lflaherty/ev-ecu/hardware/kicad_project/AIN_sim.png

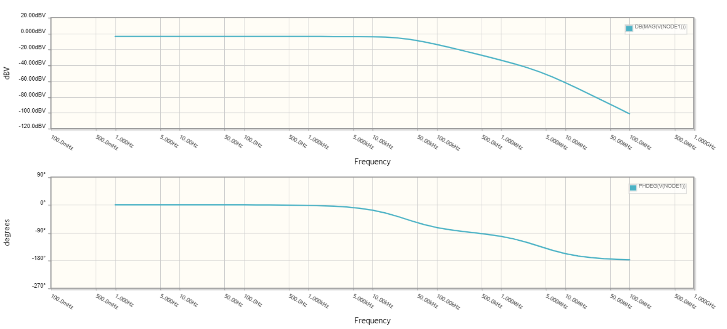
hardware/kicad_project/AIN_sim.png
