lflaherty/ev-ecu/hardware/kicad_project/GPS Antenna.SLDASM

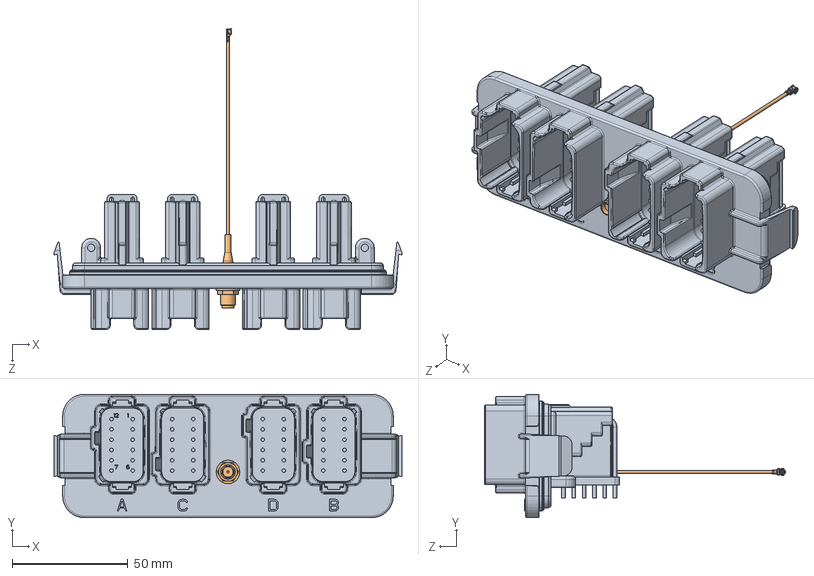
[picture p2: CAD file, 2026-08-13]
hardware/kicad_project/GPS Antenna.SLDASM
150.2 x 53.3 x 130.0 mm
c-dt13-48pabcd-r015-99-3d - COLOUR
SMA(F)-MHF-IPEX (F)-U.FL-LP-068-0.35m.step
