lflaherty/ev-ecu/hardware/kicad_project/ECU.kicad_pcb

## KiCad design hardware/kicad_project/ECU.kicad_pcb (2026-08-13)

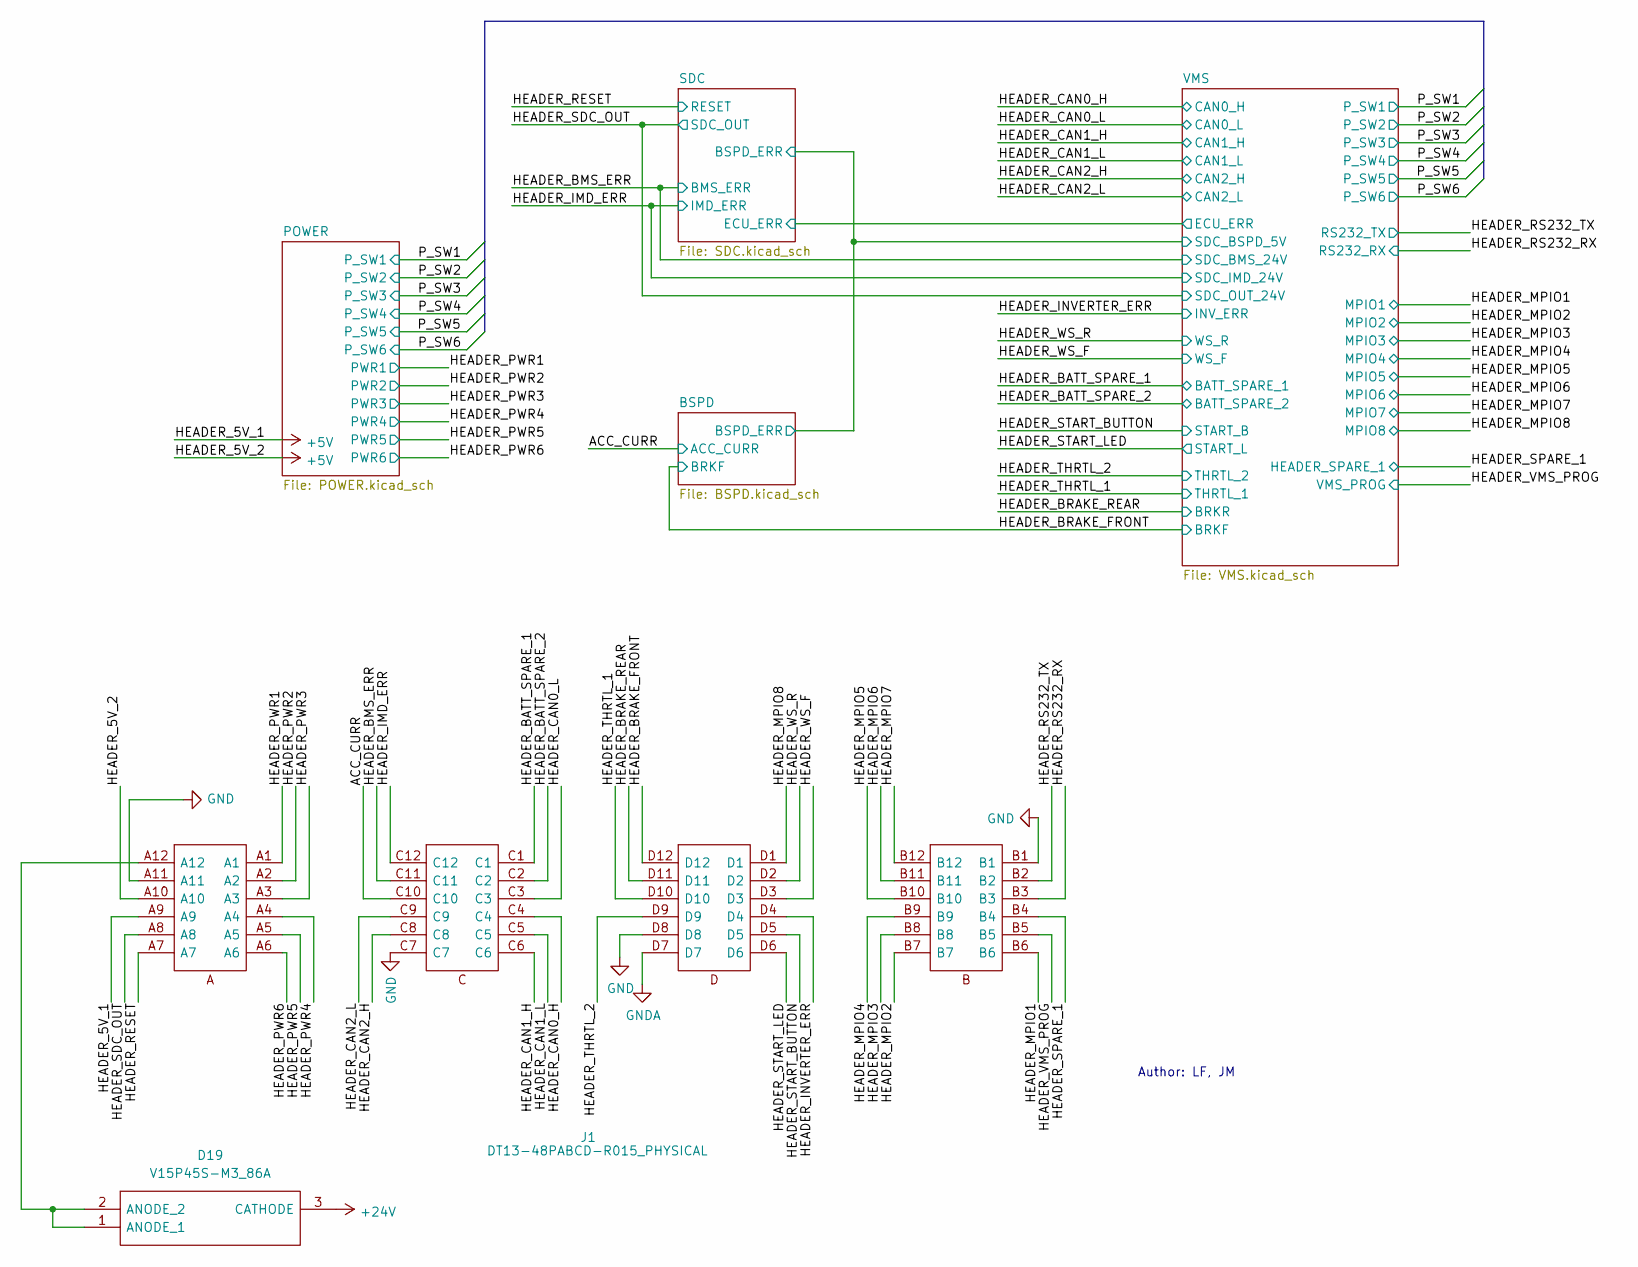
[picture p20: schematic ECU.kicad_sch]

Parts:
D19: V15P45S-M3_86A; V15P45SM387A; Manufacturer_Part_Number V15P45S-M3/87A; Mouser Part Number 78-V15P45S-M387A
J1: DT13-48PABCD-R015_PHYSICAL; DT1348PABCDR015_PHYSICAL; Manufacturer_Part_Number DT13-48PABCD-R015; Mouser Part Number 571-DT13-48PABCDR015

Connections:
+5V: J1.A9, J1.A10; also elsewhere on the board
+24V: D19.3 (CATHODE); also elsewhere on the board
/BSPD/ACC_CURR: J1.C10; also elsewhere on the board
/BSPD/BRKF: J1.D12; also elsewhere on the board
/POWER/PWR1: J1.A1; also elsewhere on the board
/POWER/PWR2: J1.A2; also elsewhere on the board
/POWER/PWR3: J1.A3; also elsewhere on the board
/POWER/PWR4: J1.A4; also elsewhere on the board
/POWER/PWR5: J1.A5; also elsewhere on the board
/POWER/PWR6: J1.A6; also elsewhere on the board
/SDC/BMS_ERR: J1.C11; also elsewhere on the board
/SDC/IMD_ERR: J1.C12; also elsewhere on the board
/SDC/RESET: J1.A7; also elsewhere on the board
/SDC/SDC_OUT: J1.A8; also elsewhere on the board
/VMS/BATT_SPARE_1: J1.C1; also elsewhere on the board
/VMS/BATT_SPARE_2: J1.C2; also elsewhere on the board
/VMS/BRKR: J1.D11; also elsewhere on the board
/VMS/CAN0_H: J1.C3; also elsewhere on the board
/VMS/CAN0_L: J1.C4; also elsewhere on the board
/VMS/CAN1_H: J1.C5; also elsewhere on the board
/VMS/CAN1_L: J1.C6; also elsewhere on the board
/VMS/CAN2_H: J1.C9; also elsewhere on the board
/VMS/CAN2_L: J1.C8; also elsewhere on the board
/VMS/HEADER_SPARE_1: J1.B4; also elsewhere on the board
/VMS/INV_ERR: J1.D4; also elsewhere on the board
/VMS/MPIO/MPIO1: J1.B6; also elsewhere on the board
/VMS/MPIO/MPIO2: J1.B7; also elsewhere on the board
/VMS/MPIO/MPIO3: J1.B8; also elsewhere on the board
/VMS/MPIO/MPIO4: J1.B9; also elsewhere on the board
/VMS/MPIO/MPIO5: J1.B10; also elsewhere on the board
/VMS/MPIO/MPIO6: J1.B11; also elsewhere on the board
/VMS/MPIO/MPIO7: J1.B12; also elsewhere on the board
/VMS/MPIO/MPIO8: J1.D1; also elsewhere on the board
/VMS/RS232_RX: J1.B3; also elsewhere on the board
/VMS/RS232_TX: J1.B2; also elsewhere on the board
/VMS/START_B: J1.D5; also elsewhere on the board
/VMS/START_L: J1.D6; also elsewhere on the board
/VMS/THRTL_1: J1.D10; also elsewhere on the board
/VMS/THRTL_2: J1.D9; also elsewhere on the board
/VMS/VMS_PROG: J1.B5; also elsewhere on the board
/VMS/WS_F: J1.D3; also elsewhere on the board
/VMS/WS_R: J1.D2; also elsewhere on the board
GND: J1.A11, J1.B1, J1.C7, J1.D8; also elsewhere on the board
GNDA: J1.D7
unnamed: D19.1 (ANODE_1), D19.2 (ANODE_2), J1.A12

Notes on the sheet:
Author: LF, JM

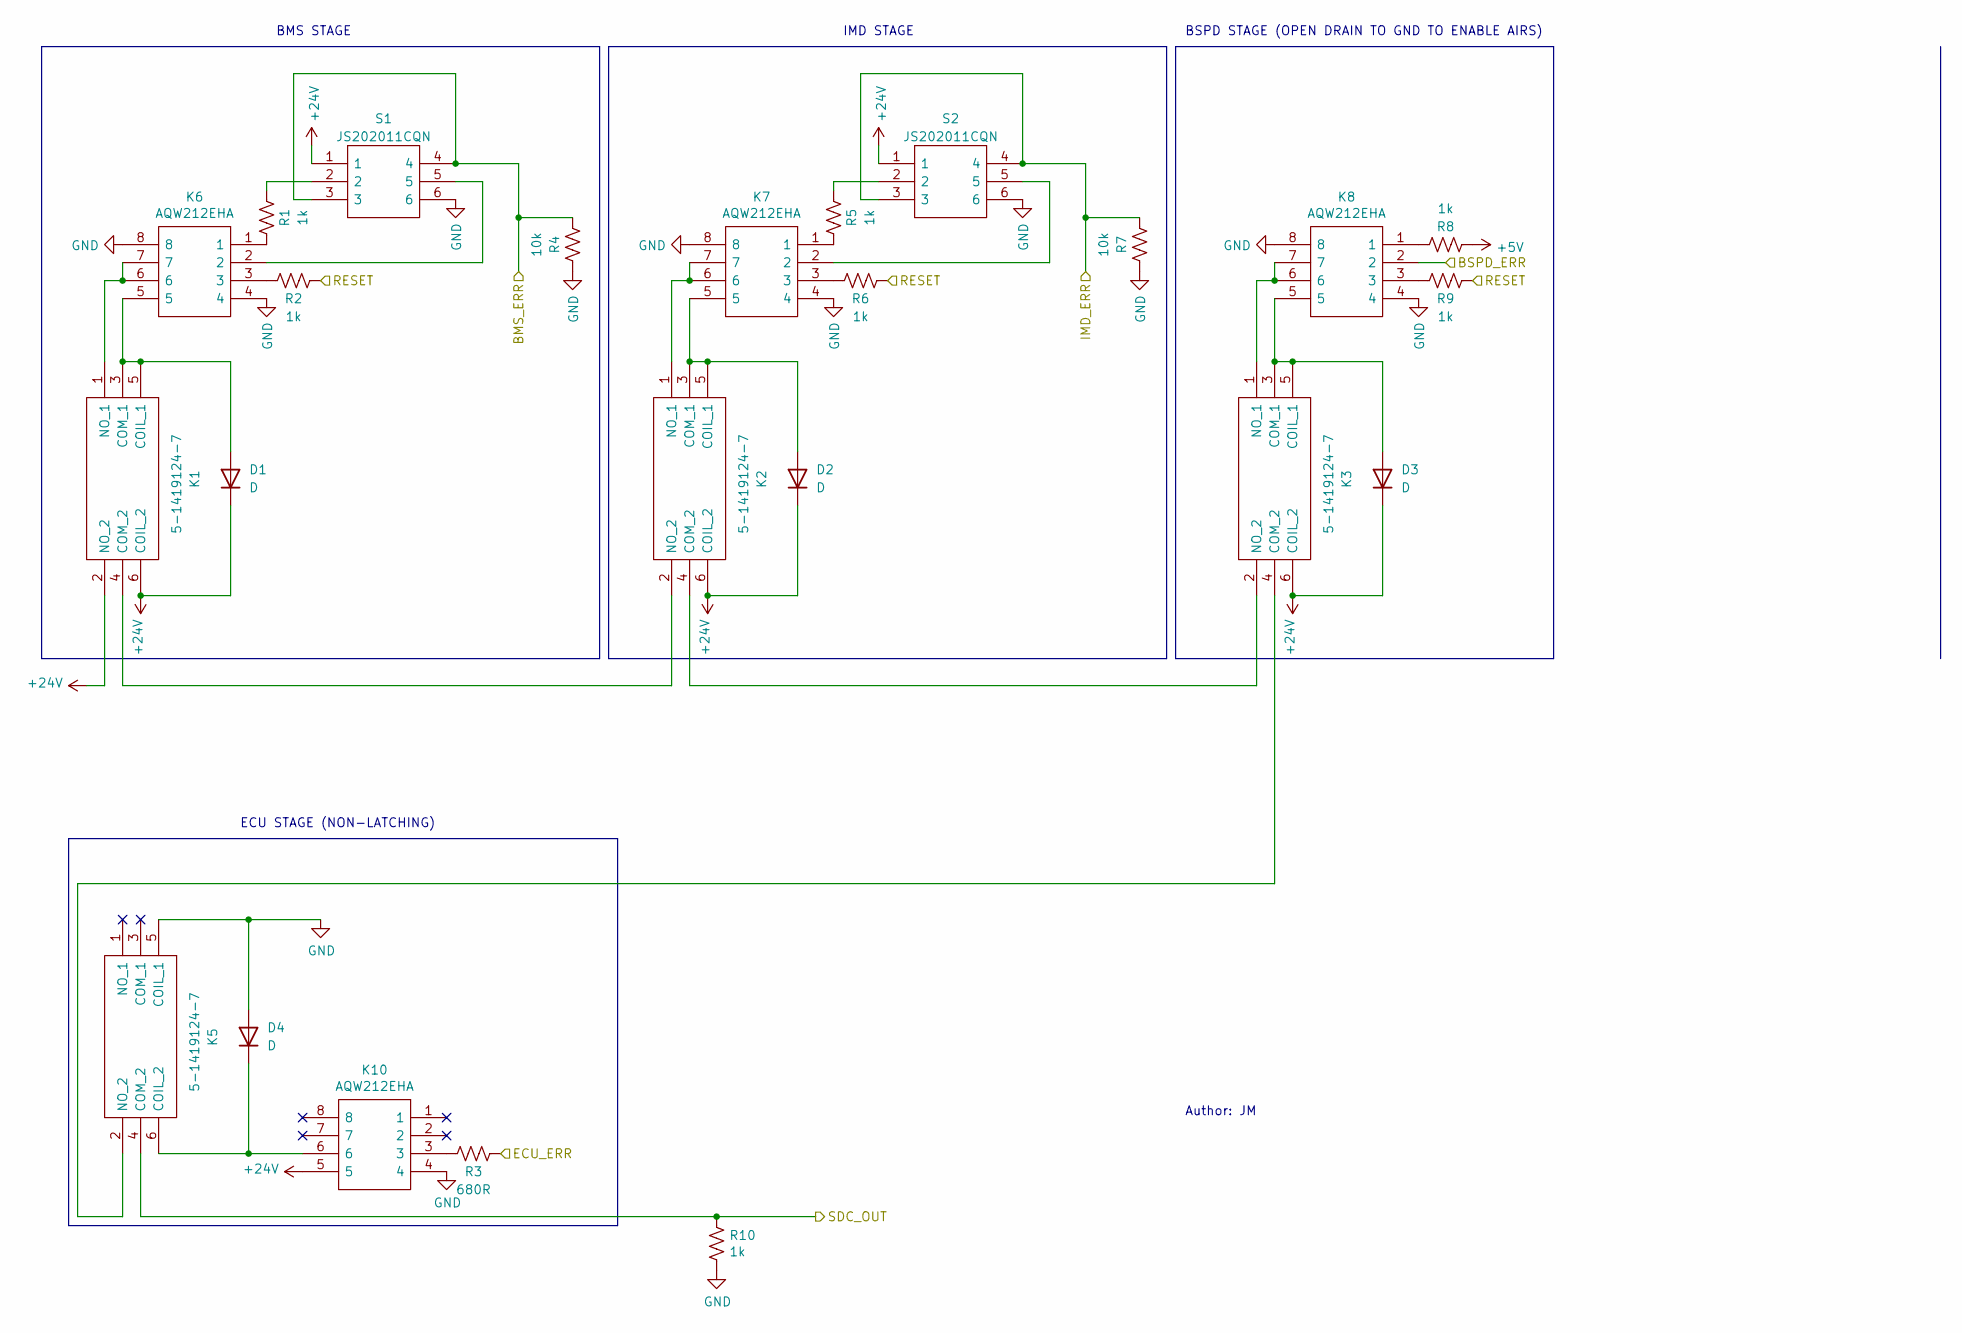
[picture p21: schematic SDC.kicad_sch]

Parts:
D1, D2, D3, D4: D; D_SMA
K1, K2, K3, K5: 5-1419124-7; 514191247; Manufacturer_Part_Number 5-1419124-7; Mouser Part Number 655-5-1419124-7
K6, K7, K8, K10: AQW212EHA; SOP254P962X275-8N; Manufacturer_Part_Number AQW212EHA; Mouser Part Number 769-AQW212EHA
R1, R2, R5, R6, R8, R9, R10: 1k; R_0805_2012Metric
R3: 680R; R_0805_2012Metric
R4, R7: 10k; R_0805_2012Metric
S1, S2: JS202011CQN; Manufacturer_Part_Number JS202011CQN; Mouser Part Number 611-JS202011CQN

Connections:
+5V: R8.2; also elsewhere on the board
+24V: D1.1 (K), D2.1 (K), D3.1 (K), K1.2 (NO_2), K1.6 (COIL_2), K2.6 (COIL_2), K3.6 (COIL_2), K10.5, S1.1, S2.1; also elsewhere on the board
/BSPD/BSPD_ERR: K8.2; also elsewhere on the board
/SDC/BMS_ERR: R4.2, S1.3, S1.4; also elsewhere on the board
/SDC/ECU_ERR: R3.1; also elsewhere on the board
/SDC/IMD_ERR: R7.2, S2.3, S2.4; also elsewhere on the board
/SDC/RESET: R2.1, R6.1, R9.1; also elsewhere on the board
/SDC/SDC_OUT: K5.4 (COM_2), R10.1; also elsewhere on the board
GND: D4.2 (A), K5.5 (COIL_1), K6.4, K6.8, K7.4, K7.8, K8.4, K8.8, K10.4, R4.1, R7.1, R10.2, S1.6, S2.6; also elsewhere on the board
unnamed: D1.2 (A), K1.3 (COM_1), K1.5 (COIL_1), K6.5
unnamed: D2.2 (A), K2.3 (COM_1), K2.5 (COIL_1), K7.5
unnamed: D3.2 (A), K3.3 (COM_1), K3.5 (COIL_1), K8.5
unnamed: D4.1 (K), K5.6 (COIL_2), K10.6
unnamed: K1.1 (NO_1), K6.6, K6.7
unnamed: K1.4 (COM_2), K2.2 (NO_2)
unnamed: K2.1 (NO_1), K7.6, K7.7
unnamed: K2.4 (COM_2), K3.2 (NO_2)
unnamed: K3.1 (NO_1), K8.6, K8.7
unnamed: K3.4 (COM_2), K5.2 (NO_2)
unnamed: K6.1, R1.2
unnamed: K6.2, S1.5
unnamed: K6.3, R2.2
unnamed: K7.1, R5.2
unnamed: K7.2, S2.5
unnamed: K7.3, R6.2
unnamed: K8.1, R8.1
unnamed: K8.3, R9.2
unnamed: K10.3, R3.2
unnamed: R1.1, S1.2
unnamed: R5.1, S2.2

Notes on the sheet:
ECU STAGE (NON-LATCHING)
BMS STAGE
Author: JM
BSPD STAGE (OPEN DRAIN TO GND TO ENABLE AIRS)
IMD STAGE

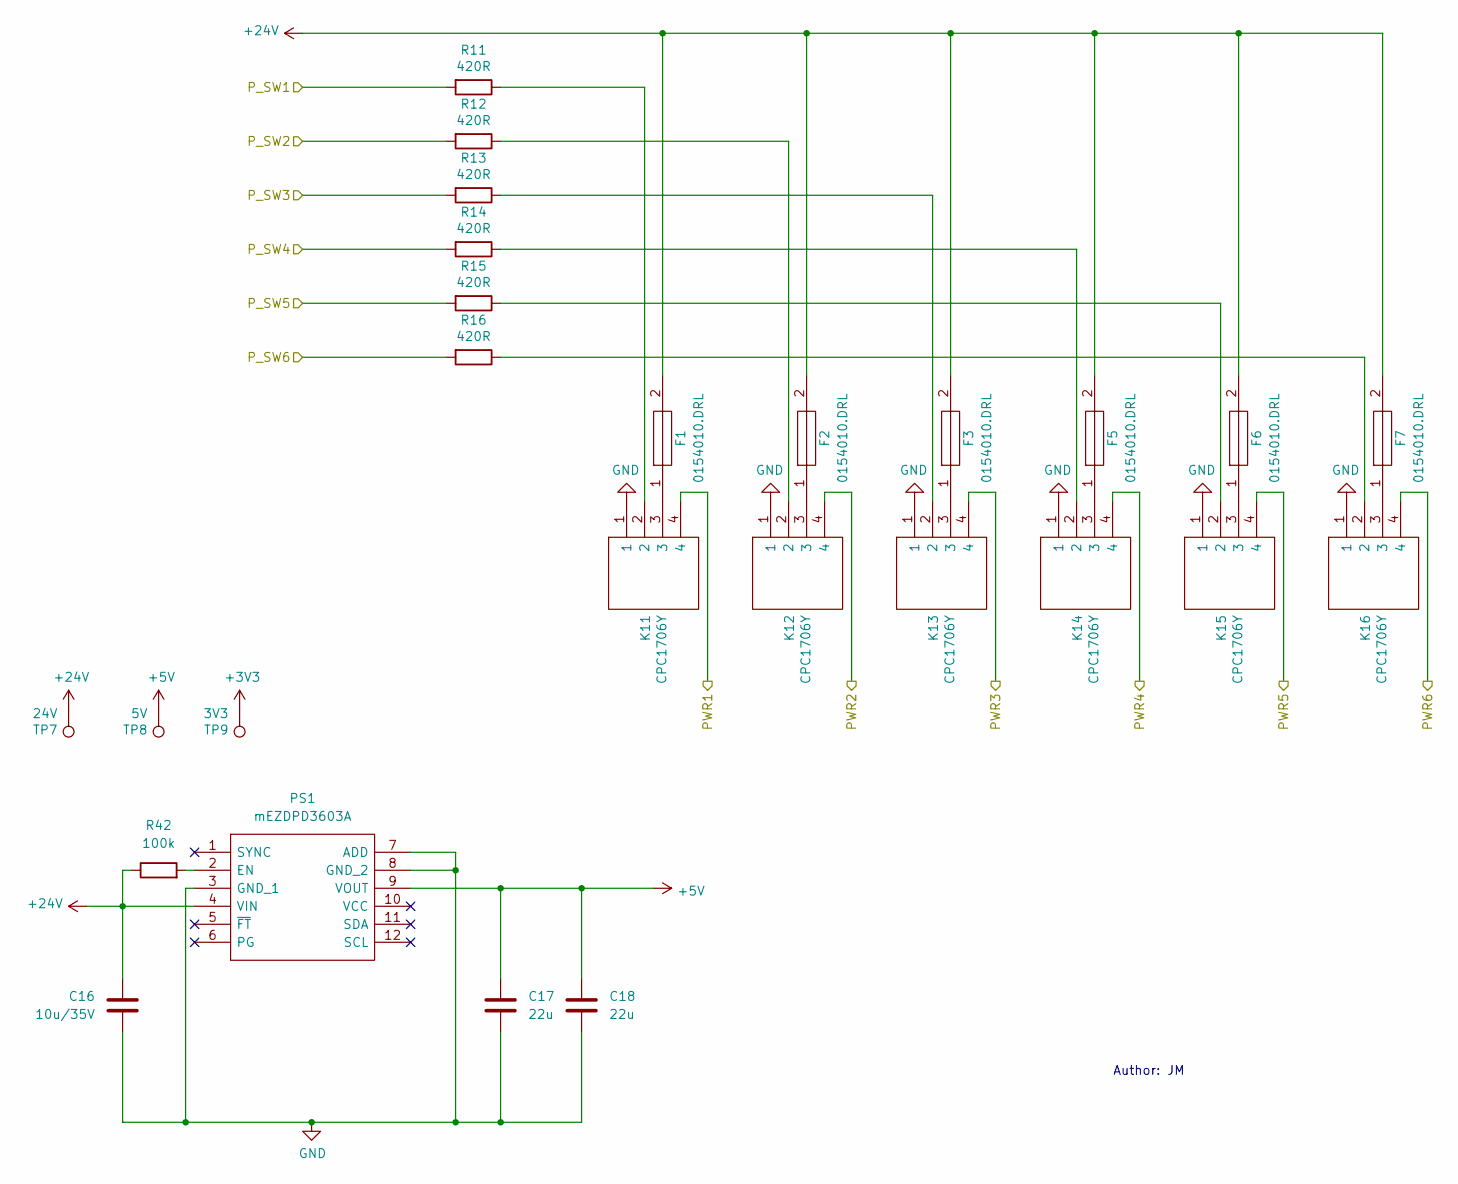
[picture p22: schematic POWER.kicad_sch]

Parts:
C16: 10u/35V; C_0805_2012Metric
C17, C18: 22u; C_1206_3216Metric
F1, F2, F3, F5, F6, F7: 0154010.DRL; 0154010DRL; Manufacturer_Part_Number 0154010.DRL; Mouser Part Number 576-0154010.DRL
K11, K12, K13, K14, K15, K16: CPC1706Y; Manufacturer_Part_Number CPC1706Y; Mouser Part Number 849-CPC1706Y
PS1: mEZDPD3603A; Manufacturer_Part_Number mEZDPD3603A; Mouser Part Number 946-MEZDPD3603A
R11, R12, R13, R14, R15, R16: 420R; R_0805_2012Metric
R42: 100k; R_0805_2012Metric
TP7: 24V; TestPoint_THTPad_D2.5mm_Drill1.2mm
TP8: 5V; TestPoint_THTPad_D2.5mm_Drill1.2mm
TP9: 3V3; TestPoint_THTPad_D2.5mm_Drill1.2mm

Connections:
+5V: C17.1, C18.1, PS1.9 (VOUT), TP8.1; also elsewhere on the board
+24V: C16.2, F1.2, F2.2, F3.2, F5.2, F6.2, F7.2, PS1.4 (VIN), R42.1, TP7.1; also elsewhere on the board
/POWER/PWR1: K11.4; also elsewhere on the board
/POWER/PWR2: K12.4; also elsewhere on the board
/POWER/PWR3: K13.4; also elsewhere on the board
/POWER/PWR4: K14.4; also elsewhere on the board
/POWER/PWR5: K15.4; also elsewhere on the board
/POWER/PWR6: K16.4; also elsewhere on the board
/POWER/P_SW1: R11.2; also elsewhere on the board
/POWER/P_SW2: R12.2; also elsewhere on the board
/POWER/P_SW3: R13.2; also elsewhere on the board
/POWER/P_SW4: R14.2; also elsewhere on the board
/POWER/P_SW5: R15.2; also elsewhere on the board
/POWER/P_SW6: R16.2; also elsewhere on the board
GND: C16.1, C17.2, C18.2, K11.1, K12.1, K13.1, K14.1, K15.1, K16.1, PS1.3 (GND_1), PS1.7 (ADD), PS1.8 (GND_2); also elsewhere on the board
unnamed: F1.1, K11.3
unnamed: F2.1, K12.3
unnamed: F3.1, K13.3
unnamed: F5.1, K14.3
unnamed: F6.1, K15.3
unnamed: F7.1, K16.3
unnamed: K11.2, R11.1
unnamed: K12.2, R12.1
unnamed: K13.2, R13.1
unnamed: K14.2, R14.1
unnamed: K15.2, R15.1
unnamed: K16.2, R16.1
unnamed: PS1.2 (EN), R42.2

Notes on the sheet:
Author: JM

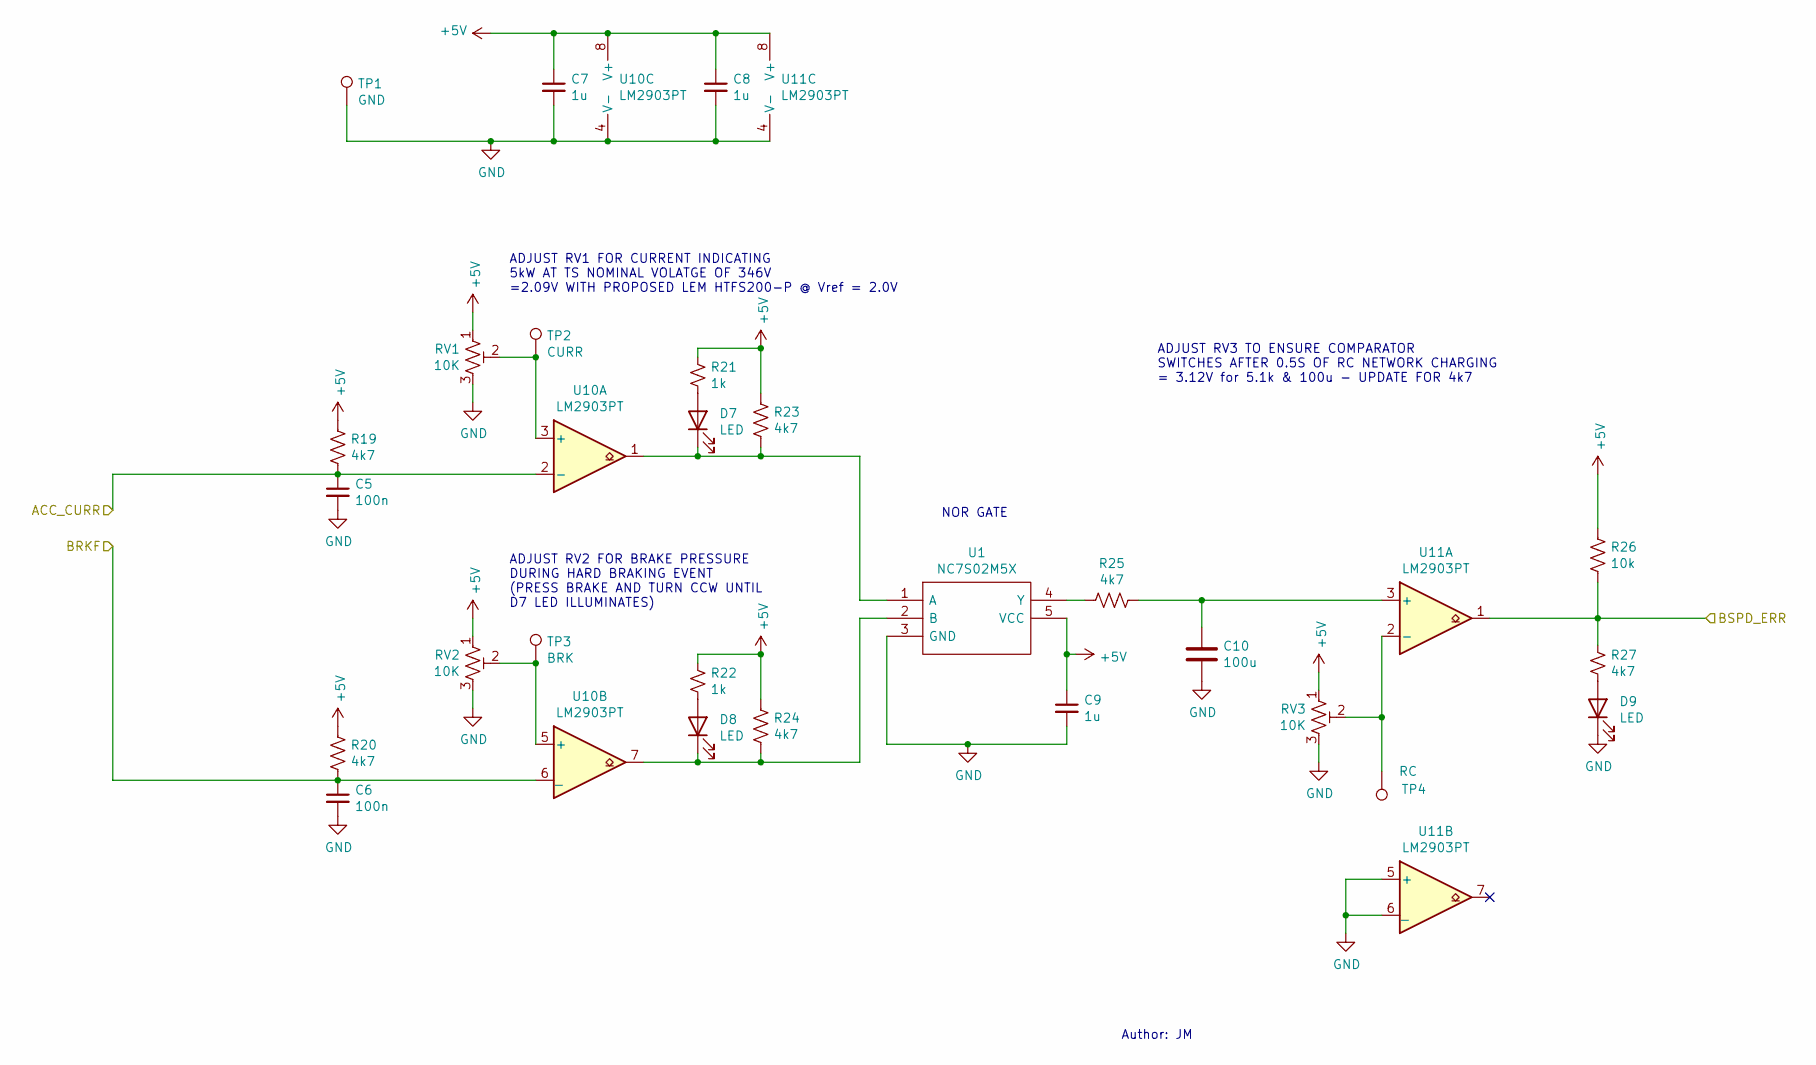
[picture p23: schematic BSPD.kicad_sch]

Parts:
C5, C6: 100n; C_0805_2012Metric
C7, C8, C9: 1u; C_0805_2012Metric
C10: 100u; C_1206_3216Metric
D7, D8, D9: LED; LED_0805_2012Metric
R19, R20, R23, R24, R25, R27: 4k7; R_0805_2012Metric
R21, R22: 1k; R_0805_2012Metric
R26: 10k; R_0805_2012Metric
RV1, RV2, RV3: 10K; 3306F1103
TP1: GND; TestPoint_THTPad_D2.5mm_Drill1.2mm
TP2: CURR; TestPoint_THTPad_D2.5mm_Drill1.2mm
TP3: BRK; TestPoint_THTPad_D2.5mm_Drill1.2mm
TP4: RC; TestPoint_THTPad_D2.5mm_Drill1.2mm
U1: NC7S02M5X; SOT95P280X125-5N; Manufacturer_Part_Number NC7S02M5X; Mouser Part Number 512-NC7S02M5X
U10, U11: LM2903PT; TSSOP-8_4.4x3mm_P0.65mm

Connections:
+5V: C7.1, C8.1, C9.1, R19.1, R20.1, R21.1, R22.1, R23.1, R24.1, R26.1, RV1.1, RV2.1, RV3.1, U1.5 (VCC), U10.8 (V+), U11.8 (V+); also elsewhere on the board
/BSPD/ACC_CURR: C5.1, R19.2, U10.2 (-); also elsewhere on the board
/BSPD/BRKF: C6.1, R20.2, U10.6 (_); also elsewhere on the board
/BSPD/BSPD_ERR: R26.2, R27.1, U11.1; also elsewhere on the board
GND: C5.2, C6.2, C7.2, C8.2, C9.2, C10.2, D9.1 (K), RV1.3, RV2.3, RV3.3, TP1.1, U1.3 (GND), U10.4 (V-), U11.4 (V-), U11.5 (+), U11.6 (_); also elsewhere on the board
unnamed: C10.1, R25.1, U11.3 (+)
unnamed: D7.1 (K), R23.2, U1.1 (A), U10.1
unnamed: D7.2 (A), R21.2
unnamed: D8.1 (K), R24.2, U1.2 (B), U10.7
unnamed: D8.2 (A), R22.2
unnamed: D9.2 (A), R27.2
unnamed: R25.2, U1.4 (Y)
unnamed: RV1.2, TP2.1, U10.3 (+)
unnamed: RV2.2, TP3.1, U10.5 (+)
unnamed: RV3.2, TP4.1, U11.2 (-)

Notes on the sheet:
ADJUST RV1 FOR CURRENT INDICATING 5kW AT TS NOMINAL VOLATGE OF 346V =2.09V WITH PROPOSED LEM HTFS200-P @ Vref = 2.0V
NOR GATE
ADJUST RV3 TO ENSURE COMPARATOR SWITCHES AFTER 0.5S OF RC NETWORK CHARGING = 3.12V for 5.1k & 100u - UPDATE FOR 4k7
Author: JM
ADJUST RV2 FOR BRAKE PRESSURE DURING HARD BRAKING EVENT (PRESS BRAKE AND TURN CCW UNTIL D7 LED ILLUMINATES)

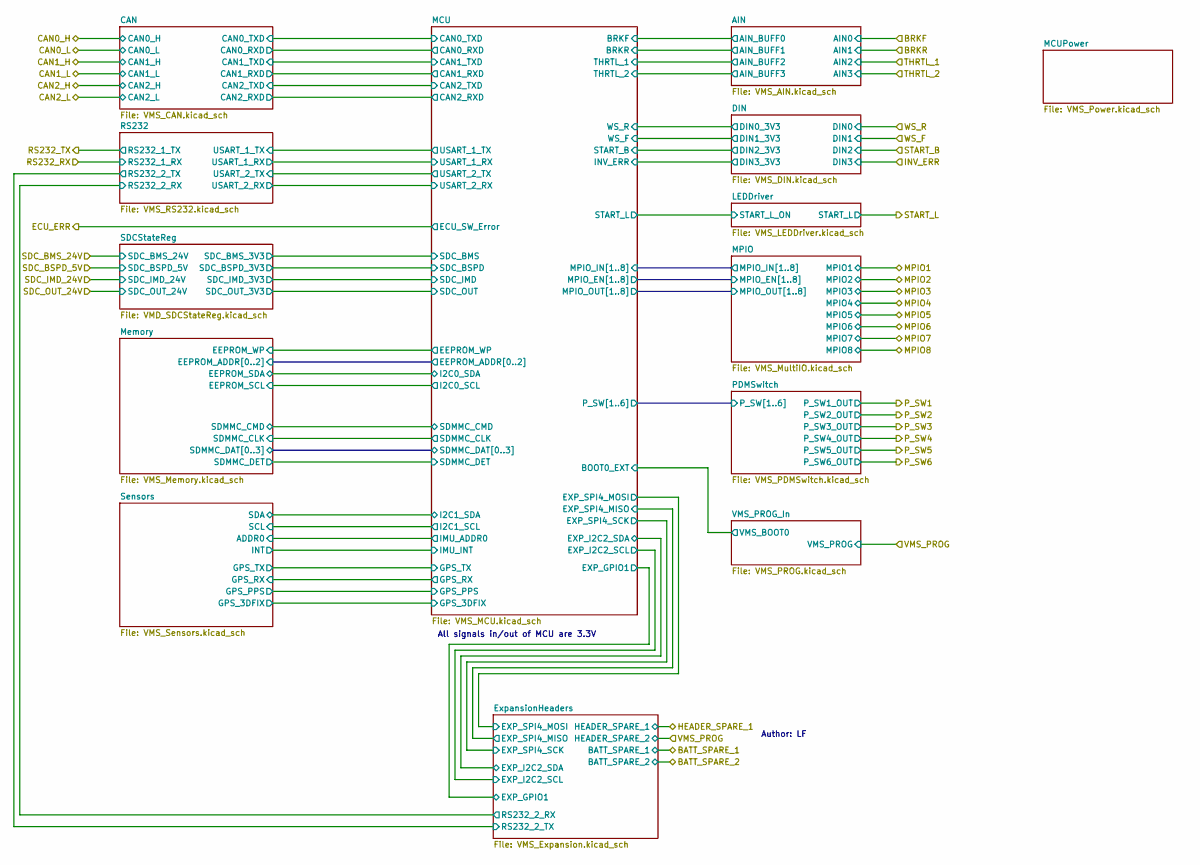
[picture p24: schematic VMS.kicad_sch]

Notes on the sheet:
All signals in/out of MCU are 3.3V
Author: LF

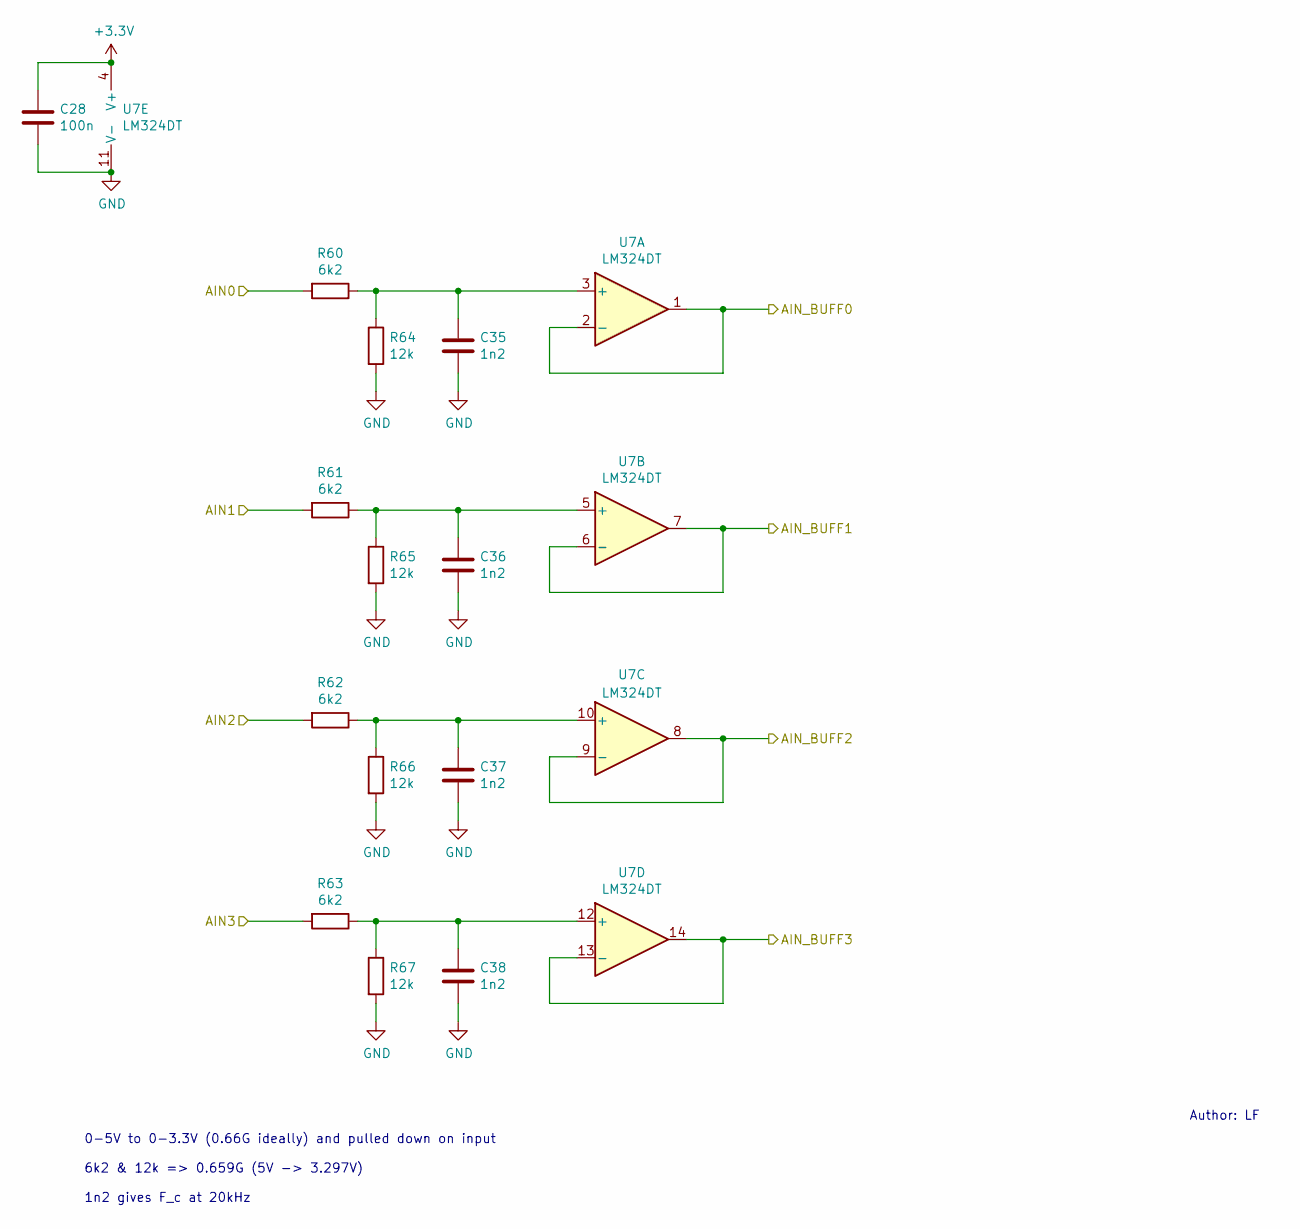
[picture p25: schematic VMS_AIN.kicad_sch]

Parts:
C28: 100n; C_0805_2012Metric
C35, C36, C37, C38: 1n2; C_0805_2012Metric
R60, R61, R62, R63: 6k2; R_0805_2012Metric
R64, R65, R66, R67: 12k; R_0805_2012Metric
U7: LM324DT; SOIC-14_3.9x8.7mm_P1.27mm

Connections:
/BSPD/BRKF: R60.2; also elsewhere on the board
/VMS/AIN/AIN_BUFF0: U7.1, U7.2 (-); also elsewhere on the board
/VMS/AIN/AIN_BUFF1: U7.6 (-), U7.7; also elsewhere on the board
/VMS/AIN/AIN_BUFF2: U7.8, U7.9 (-); also elsewhere on the board
/VMS/AIN/AIN_BUFF3: U7.13 (-), U7.14; also elsewhere on the board
/VMS/BRKR: R61.2; also elsewhere on the board
/VMS/THRTL_1: R62.2; also elsewhere on the board
/VMS/THRTL_2: R63.2; also elsewhere on the board
GND: C28.2, C35.2, C36.2, C37.2, C38.2, R64.2, R65.2, R66.2, R67.2, U7.11 (V-); also elsewhere on the board
unnamed: C35.1, R60.1, R64.1, U7.3 (+)
unnamed: C36.1, R61.1, R65.1, U7.5 (+)
unnamed: C37.1, R62.1, R66.1, U7.10 (+)
unnamed: C38.1, R63.1, R67.1, U7.12 (+)

Notes on the sheet:
0-5V to 0-3.3V (0.66G ideally) and pulled down on input 6k2 & 12k => 0.659G (5V -> 3.297V) 1n2 gives F_c at 20kHz
Author: LF

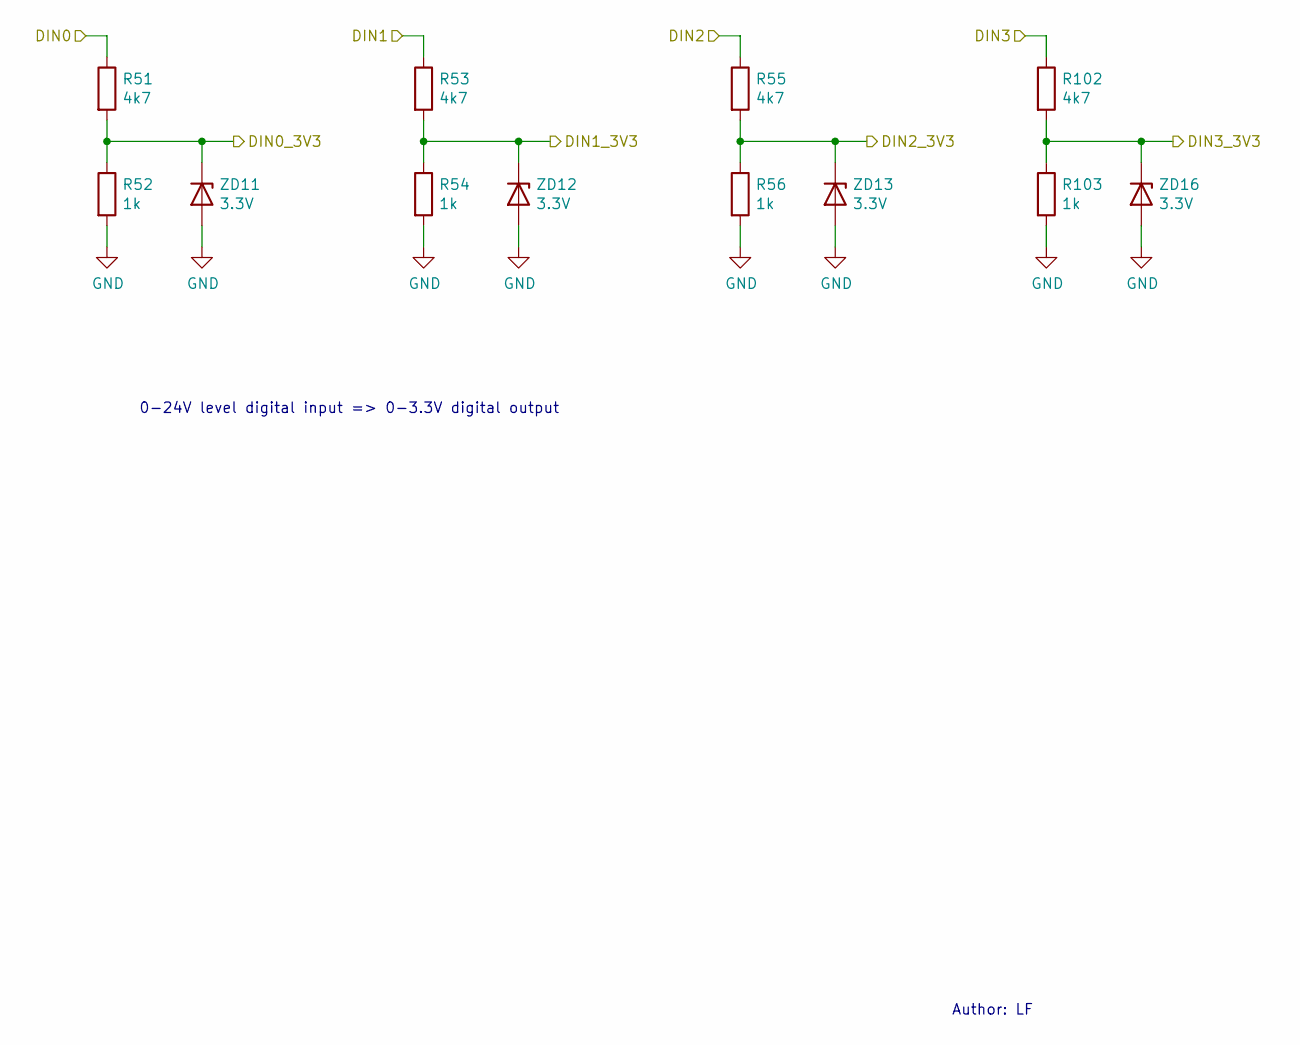
[picture p26: schematic VMS_DIN.kicad_sch]

Parts:
R51, R53, R55, R102: 4k7; R_0805_2012Metric
R52, R54, R56, R103: 1k; R_0805_2012Metric
ZD11, ZD12, ZD13, ZD16: 3.3V; D_MiniMELF

Connections:
/VMS/DIN/DIN0_3V3: R51.2, R52.1, ZD11.1 (K); also elsewhere on the board
/VMS/DIN/DIN1_3V3: R53.2, R54.1, ZD12.1 (K); also elsewhere on the board
/VMS/DIN/DIN2_3V3: R55.2, R56.1, ZD13.1 (K); also elsewhere on the board
/VMS/DIN/DIN3_3V3: R102.2, R103.1, ZD16.1 (K); also elsewhere on the board
/VMS/INV_ERR: R102.1; also elsewhere on the board
/VMS/START_B: R55.1; also elsewhere on the board
/VMS/WS_F: R53.1; also elsewhere on the board
/VMS/WS_R: R51.1; also elsewhere on the board
GND: R52.2, R54.2, R56.2, R103.2, ZD11.2 (A), ZD12.2 (A), ZD13.2 (A), ZD16.2 (A); also elsewhere on the board

Notes on the sheet:
Author: LF
0-24V level digital input => 0-3.3V digital output

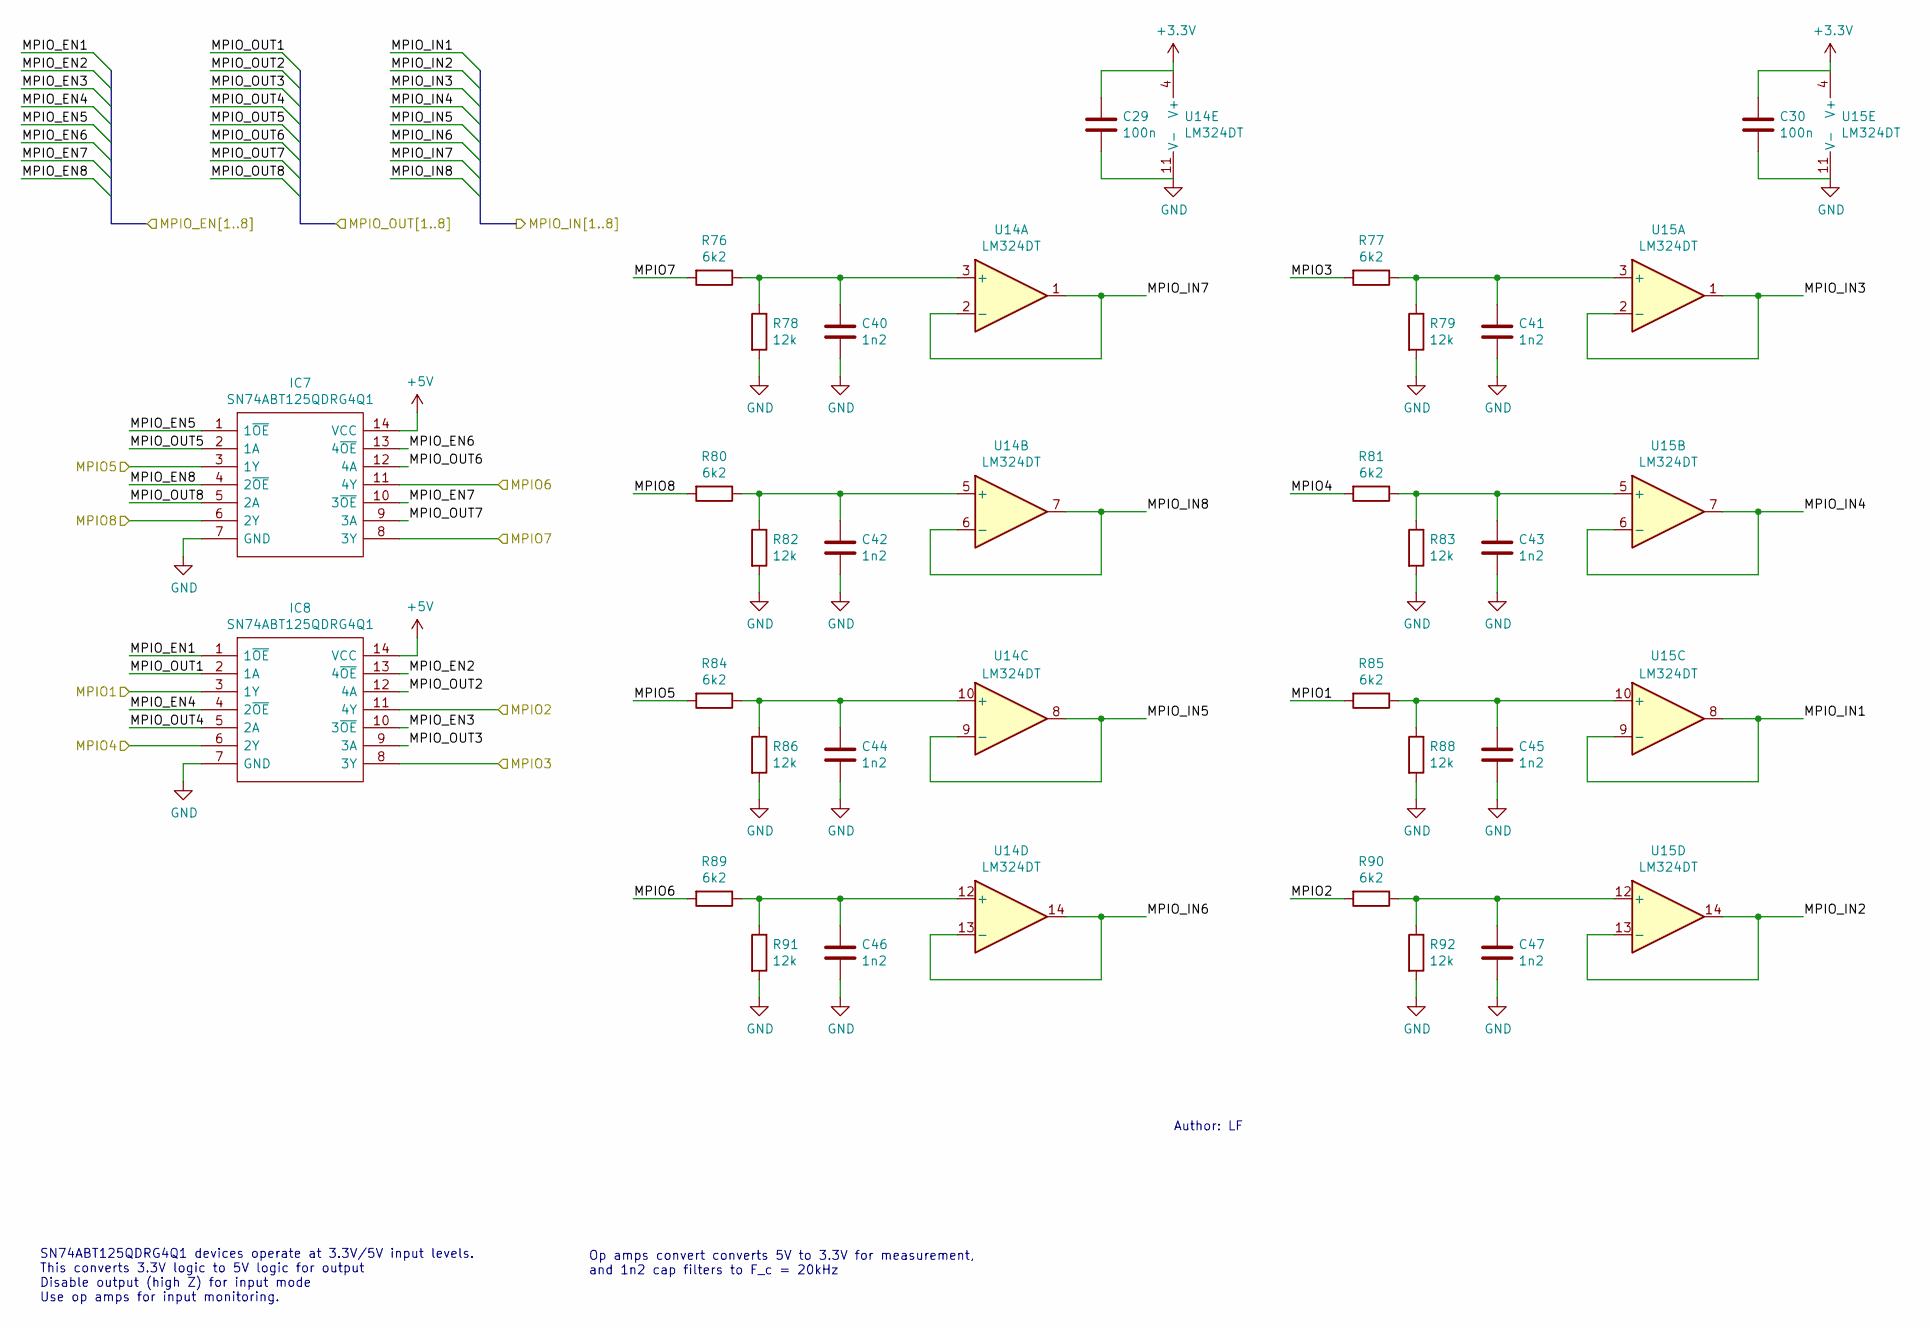
[picture p27: schematic VMS_MultiIO.kicad_sch]

Parts:
C29, C30: 100n; C_0805_2012Metric
C40, C41, C42, C43, C44, C45, C46, C47: 1n2; C_0805_2012Metric
IC7, IC8: SN74ABT125QDRG4Q1; SOIC-14_3.9x8.7mm_P1.27mm; Manufacturer_Part_Number SN74ABT125QDRG4Q1; Mouser Part Number 595-N74ABT125QDRG4Q1
R76, R77, R80, R81, R84, R85, R89, R90: 6k2; R_0805_2012Metric
R78, R79, R82, R83, R86, R88, R91, R92: 12k; R_0805_2012Metric
U14, U15: LM324DT; SOIC-14_3.9x8.7mm_P1.27mm

Connections:
+5V: IC7.14 (VCC), IC8.14 (VCC); also elsewhere on the board
/VMS/MCU/MPIO_EN1: IC8.1 (1~OE); also elsewhere on the board
/VMS/MCU/MPIO_EN2: IC8.13 (4~OE); also elsewhere on the board
/VMS/MCU/MPIO_EN3: IC8.10 (3~OE); also elsewhere on the board
/VMS/MCU/MPIO_EN4: IC8.4 (2~OE); also elsewhere on the board
/VMS/MCU/MPIO_EN5: IC7.1 (1~OE); also elsewhere on the board
/VMS/MCU/MPIO_EN6: IC7.13 (4~OE); also elsewhere on the board
/VMS/MCU/MPIO_EN7: IC7.10 (3~OE); also elsewhere on the board
/VMS/MCU/MPIO_EN8: IC7.4 (2~OE); also elsewhere on the board
/VMS/MCU/MPIO_IN1: U15.8, U15.9 (-); also elsewhere on the board
/VMS/MCU/MPIO_IN2: U15.13 (-), U15.14; also elsewhere on the board
/VMS/MCU/MPIO_IN3: U15.1, U15.2 (-); also elsewhere on the board
/VMS/MCU/MPIO_IN4: U15.6 (-), U15.7; also elsewhere on the board
/VMS/MCU/MPIO_IN5: U14.8, U14.9 (-); also elsewhere on the board
/VMS/MCU/MPIO_IN6: U14.13 (-), U14.14; also elsewhere on the board
/VMS/MCU/MPIO_IN7: U14.1, U14.2 (-); also elsewhere on the board
/VMS/MCU/MPIO_IN8: U14.6 (-), U14.7; also elsewhere on the board
/VMS/MCU/MPIO_OUT1: IC8.2 (1A); also elsewhere on the board
/VMS/MCU/MPIO_OUT2: IC8.12 (4A); also elsewhere on the board
/VMS/MCU/MPIO_OUT3: IC8.9 (3A); also elsewhere on the board
/VMS/MCU/MPIO_OUT4: IC8.5 (2A); also elsewhere on the board
/VMS/MCU/MPIO_OUT5: IC7.2 (1A); also elsewhere on the board
/VMS/MCU/MPIO_OUT6: IC7.12 (4A); also elsewhere on the board
/VMS/MCU/MPIO_OUT7: IC7.9 (3A); also elsewhere on the board
/VMS/MCU/MPIO_OUT8: IC7.5 (2A); also elsewhere on the board
/VMS/MPIO/MPIO1: IC8.3 (1Y), R85.2; also elsewhere on the board
/VMS/MPIO/MPIO2: IC8.11 (4Y), R90.2; also elsewhere on the board
/VMS/MPIO/MPIO3: IC8.8 (3Y), R77.2; also elsewhere on the board
/VMS/MPIO/MPIO4: IC8.6 (2Y), R81.2; also elsewhere on the board
/VMS/MPIO/MPIO5: IC7.3 (1Y), R84.2; also elsewhere on the board
/VMS/MPIO/MPIO6: IC7.11 (4Y), R89.2; also elsewhere on the board
/VMS/MPIO/MPIO7: IC7.8 (3Y), R76.2; also elsewhere on the board
/VMS/MPIO/MPIO8: IC7.6 (2Y), R80.2; also elsewhere on the board
GND: C29.2, C30.2, C40.2, C41.2, C42.2, C43.2, C44.2, C45.2, C46.2, C47.2, IC7.7 (GND), IC8.7 (GND), R78.2, R79.2, R82.2, R83.2, R86.2, R88.2, R91.2, R92.2, U14.11 (V-), U15.11 (V-); also elsewhere on the board
unnamed: C40.1, R76.1, R78.1, U14.3 (+)
unnamed: C41.1, R77.1, R79.1, U15.3 (+)
unnamed: C42.1, R80.1, R82.1, U14.5 (+)
unnamed: C43.1, R81.1, R83.1, U15.5 (+)
unnamed: C44.1, R84.1, R86.1, U14.10 (+)
unnamed: C45.1, R85.1, R88.1, U15.10 (+)
unnamed: C46.1, R89.1, R91.1, U14.12 (+)
unnamed: C47.1, R90.1, R92.1, U15.12 (+)

Notes on the sheet:
SN74ABT125QDRG4Q1 devices operate at 3.3V/5V input levels. This converts 3.3V logic to 5V logic for output Disable output (high Z) for input mode Use op amps for input monitoring.
Author: LF
Op amps convert converts 5V to 3.3V for measurement, and 1n2 cap filters to F_c = 20kHz
