lflaherty/ev-ecu/hardware/kicad_project/ECU.kicad_pcb

## KiCad design hardware/kicad_project/ECU.kicad_pcb (continued)

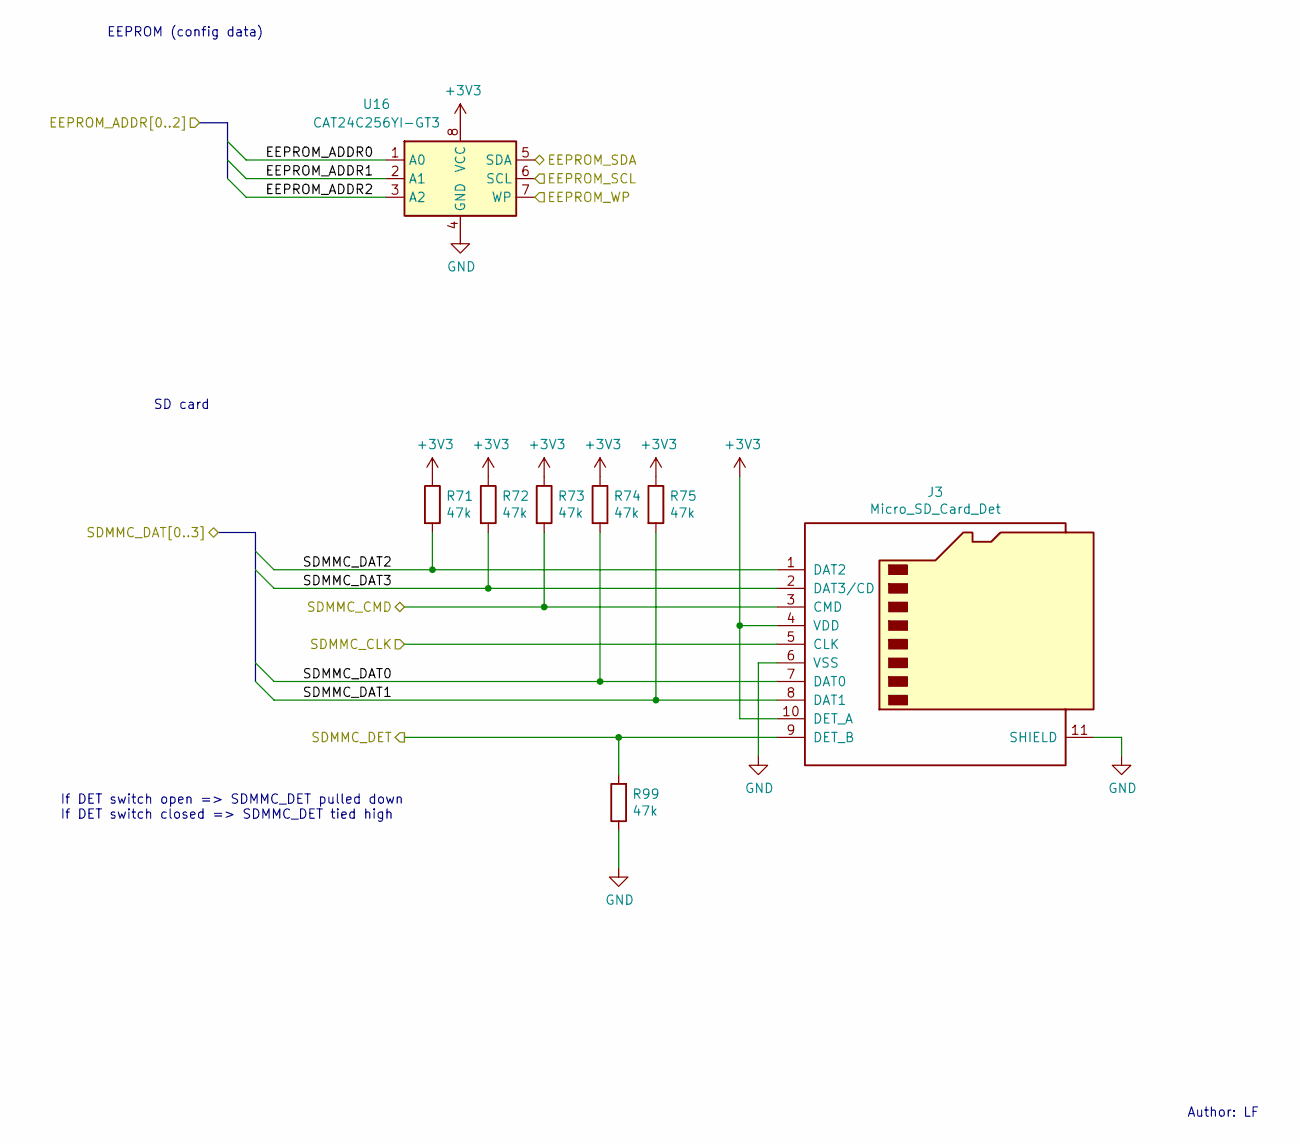
[picture p28: schematic VMS_Memory.kicad_sch]

Parts:
J3: Micro_SD_Card_Det; microSD_HC_Molex_104031-0811
R71, R72, R73, R74, R75, R99: 47k; R_0805_2012Metric
U16: CAT24C256YI-GT3; TSSOP-8_4.4x3mm_P0.65mm

Connections:
/VMS/MCU/EEPROM_ADDR0: U16.1 (A0); also elsewhere on the board
/VMS/MCU/EEPROM_ADDR1: U16.2 (A1); also elsewhere on the board
/VMS/MCU/EEPROM_ADDR2: U16.3 (A2); also elsewhere on the board
/VMS/MCU/EEPROM_WP: U16.7 (WP); also elsewhere on the board
/VMS/MCU/I2C0_SCL: U16.6 (SCL); also elsewhere on the board
/VMS/MCU/I2C0_SDA: U16.5 (SDA); also elsewhere on the board
/VMS/MCU/SDMMC_CLK: J3.5 (CLK); also elsewhere on the board
/VMS/MCU/SDMMC_CMD: J3.3 (CMD), R73.2; also elsewhere on the board
/VMS/MCU/SDMMC_DAT0: J3.7 (DAT0), R74.2; also elsewhere on the board
/VMS/MCU/SDMMC_DAT1: J3.8 (DAT1), R75.2; also elsewhere on the board
/VMS/MCU/SDMMC_DAT2: J3.1 (DAT2), R71.2; also elsewhere on the board
/VMS/MCU/SDMMC_DAT3: J3.2 (DAT3/CD), R72.2; also elsewhere on the board
/VMS/MCU/SDMMC_DET: J3.9 (DET_B), R99.2; also elsewhere on the board
GND: J3.6 (VSS), J3.11 (SHIELD), R99.1, U16.4 (GND); also elsewhere on the board

Notes on the sheet:
Author: LF
EEPROM (config data)
If DET switch open => SDMMC_DET pulled down If DET switch closed => SDMMC_DET tied high
SD card

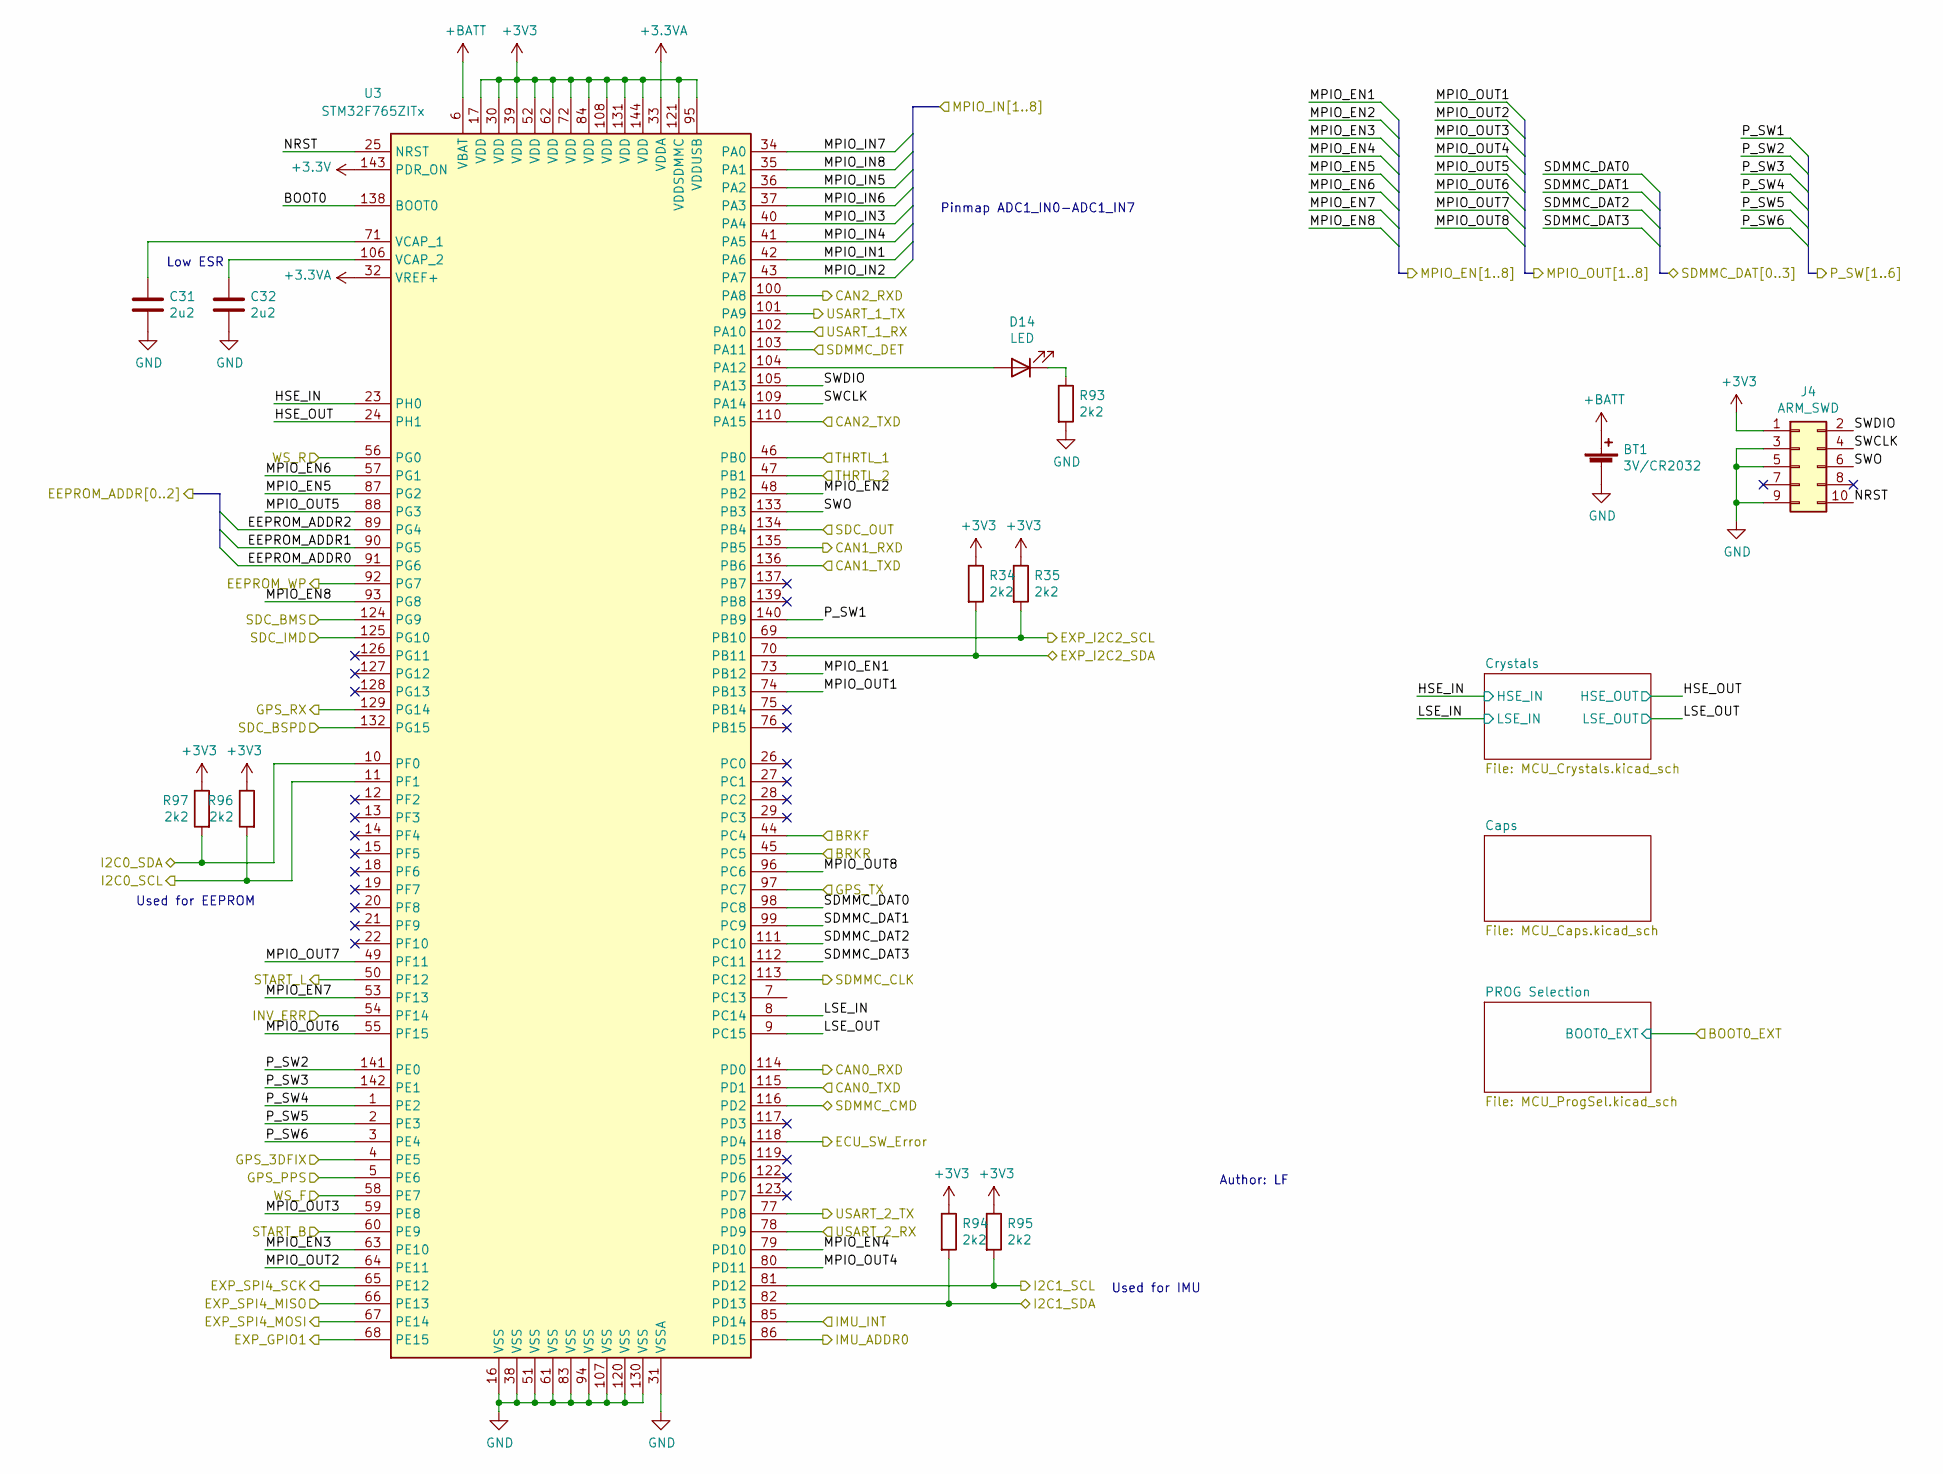
[picture p29: schematic VMS_MCU.kicad_sch]

Parts:
BT1: 3V/CR2032; BatteryHolder_Keystone_1060_1x2032
C31, C32: 2u2; C_0805_2012Metric
D14: LED; LED_0805_2012Metric
J4: ARM_SWD; PinHeader_2x05_P1.27mm_Vertical_SMD
R34, R35, R93, R94, R95, R96, R97: 2k2; R_0805_2012Metric
U3: STM32F765ZITx; LQFP-144_20x20mm_P0.5mm

Connections:
+3.3VA: U3.32 (VREF+), U3.33 (VDDA); also elsewhere on the board
+BATT: BT1.1 (+), U3.6 (VBAT); also elsewhere on the board
/SDC/ECU_ERR: U3.118 (PD4); also elsewhere on the board
/VMS/AIN/AIN_BUFF0: U3.44 (PC4); also elsewhere on the board
/VMS/AIN/AIN_BUFF1: U3.45 (PC5); also elsewhere on the board
/VMS/AIN/AIN_BUFF2: U3.46 (PB0); also elsewhere on the board
/VMS/AIN/AIN_BUFF3: U3.47 (PB1); also elsewhere on the board
/VMS/CAN/CAN0_RXD: U3.114 (PD0); also elsewhere on the board
/VMS/CAN/CAN0_TXD: U3.115 (PD1); also elsewhere on the board
/VMS/CAN/CAN1_RXD: U3.135 (PB5); also elsewhere on the board
/VMS/CAN/CAN1_TXD: U3.136 (PB6); also elsewhere on the board
/VMS/CAN/CAN2_RXD: U3.100 (PA8); also elsewhere on the board
/VMS/CAN/CAN2_TXD: U3.110 (PA15); also elsewhere on the board
/VMS/DIN/DIN0_3V3: U3.56 (PG0); also elsewhere on the board
/VMS/DIN/DIN1_3V3: U3.58 (PE7); also elsewhere on the board
/VMS/DIN/DIN2_3V3: U3.60 (PE9); also elsewhere on the board
/VMS/DIN/DIN3_3V3: U3.54 (PF14); also elsewhere on the board
/VMS/ExpansionHeaders/EXP_GPIO1: U3.68 (PE15); also elsewhere on the board
/VMS/ExpansionHeaders/EXP_I2C2_SCL: R35.2, U3.69 (PB10); also elsewhere on the board
/VMS/ExpansionHeaders/EXP_I2C2_SDA: R34.2, U3.70 (PB11); also elsewhere on the board
/VMS/ExpansionHeaders/EXP_SPI4_MISO: U3.66 (PE13); also elsewhere on the board
/VMS/ExpansionHeaders/EXP_SPI4_MOSI: U3.67 (PE14); also elsewhere on the board
/VMS/ExpansionHeaders/EXP_SPI4_SCK: U3.65 (PE12); also elsewhere on the board
/VMS/LEDDriver/START_L_ON: U3.50 (PF12); also elsewhere on the board
/VMS/MCU/BOOT0: U3.138 (BOOT0); also elsewhere on the board
/VMS/MCU/EEPROM_ADDR0: U3.91 (PG6); also elsewhere on the board
/VMS/MCU/EEPROM_ADDR1: U3.90 (PG5); also elsewhere on the board
/VMS/MCU/EEPROM_ADDR2: U3.89 (PG4); also elsewhere on the board
/VMS/MCU/EEPROM_WP: U3.92 (PG7); also elsewhere on the board
/VMS/MCU/GPS_3DFIX: U3.4 (PE5); also elsewhere on the board
/VMS/MCU/GPS_PPS: U3.5 (PE6); also elsewhere on the board
/VMS/MCU/GPS_RX: U3.129 (PG14); also elsewhere on the board
/VMS/MCU/GPS_TX: U3.97 (PC7); also elsewhere on the board
/VMS/MCU/HSE_IN: U3.23 (PH0); also elsewhere on the board
/VMS/MCU/HSE_OUT: U3.24 (PH1); also elsewhere on the board
/VMS/MCU/I2C0_SCL: R96.2, U3.11 (PF1); also elsewhere on the board
/VMS/MCU/I2C0_SDA: R97.2, U3.10 (PF0); also elsewhere on the board
/VMS/MCU/I2C1_SCL: R95.2, U3.81 (PD12); also elsewhere on the board
/VMS/MCU/I2C1_SDA: R94.2, U3.82 (PD13); also elsewhere on the board
/VMS/MCU/IMU_ADDR0: U3.86 (PD15); also elsewhere on the board
/VMS/MCU/IMU_INT: U3.85 (PD14); also elsewhere on the board
/VMS/MCU/LSE_IN: U3.8 (PC14); also elsewhere on the board
/VMS/MCU/LSE_OUT: U3.9 (PC15); also elsewhere on the board
/VMS/MCU/MPIO_EN1: U3.73 (PB12); also elsewhere on the board
/VMS/MCU/MPIO_EN2: U3.48 (PB2); also elsewhere on the board
/VMS/MCU/MPIO_EN3: U3.63 (PE10); also elsewhere on the board
/VMS/MCU/MPIO_EN4: U3.79 (PD10); also elsewhere on the board
/VMS/MCU/MPIO_EN5: U3.87 (PG2); also elsewhere on the board
/VMS/MCU/MPIO_EN6: U3.57 (PG1); also elsewhere on the board
/VMS/MCU/MPIO_EN7: U3.53 (PF13); also elsewhere on the board
/VMS/MCU/MPIO_EN8: U3.93 (PG8); also elsewhere on the board
/VMS/MCU/MPIO_IN1: U3.42 (PA6); also elsewhere on the board
/VMS/MCU/MPIO_IN2: U3.43 (PA7); also elsewhere on the board
/VMS/MCU/MPIO_IN3: U3.40 (PA4); also elsewhere on the board
/VMS/MCU/MPIO_IN4: U3.41 (PA5); also elsewhere on the board
/VMS/MCU/MPIO_IN5: U3.36 (PA2); also elsewhere on the board
/VMS/MCU/MPIO_IN6: U3.37 (PA3); also elsewhere on the board
/VMS/MCU/MPIO_IN7: U3.34 (PA0); also elsewhere on the board
/VMS/MCU/MPIO_IN8: U3.35 (PA1); also elsewhere on the board
/VMS/MCU/MPIO_OUT1: U3.74 (PB13); also elsewhere on the board
/VMS/MCU/MPIO_OUT2: U3.64 (PE11); also elsewhere on the board
/VMS/MCU/MPIO_OUT3: U3.59 (PE8); also elsewhere on the board
/VMS/MCU/MPIO_OUT4: U3.80 (PD11); also elsewhere on the board
/VMS/MCU/MPIO_OUT5: U3.88 (PG3); also elsewhere on the board
/VMS/MCU/MPIO_OUT6: U3.55 (PF15); also elsewhere on the board
/VMS/MCU/MPIO_OUT7: U3.49 (PF11); also elsewhere on the board
/VMS/MCU/MPIO_OUT8: U3.96 (PC6); also elsewhere on the board
/VMS/MCU/NRST: J4.10, U3.25 (NRST)
/VMS/MCU/P_SW1: U3.140 (PB9); also elsewhere on the board
/VMS/MCU/P_SW2: U3.141 (PE0); also elsewhere on the board
/VMS/MCU/P_SW3: U3.142 (PE1); also elsewhere on the board
/VMS/MCU/P_SW4: U3.1 (PE2); also elsewhere on the board
/VMS/MCU/P_SW5: U3.2 (PE3); also elsewhere on the board
/VMS/MCU/P_SW6: U3.3 (PE4); also elsewhere on the board
/VMS/MCU/SDC_BMS: U3.124 (PG9); also elsewhere on the board
/VMS/MCU/SDC_BSPD: U3.132 (PG15); also elsewhere on the board
/VMS/MCU/SDC_IMD: U3.125 (PG10); also elsewhere on the board
/VMS/MCU/SDC_OUT: U3.134 (PB4); also elsewhere on the board
/VMS/MCU/SDMMC_CLK: U3.113 (PC12); also elsewhere on the board
/VMS/MCU/SDMMC_CMD: U3.116 (PD2); also elsewhere on the board
/VMS/MCU/SDMMC_DAT0: U3.98 (PC8); also elsewhere on the board
/VMS/MCU/SDMMC_DAT1: U3.99 (PC9); also elsewhere on the board
/VMS/MCU/SDMMC_DAT2: U3.111 (PC10); also elsewhere on the board
/VMS/MCU/SDMMC_DAT3: U3.112 (PC11); also elsewhere on the board
/VMS/MCU/SDMMC_DET: U3.103 (PA11); also elsewhere on the board
/VMS/MCU/SWCLK: J4.4, U3.109 (PA14)
/VMS/MCU/SWDIO: J4.2, U3.105 (PA13)
/VMS/MCU/SWO: J4.6, U3.133 (PB3)
/VMS/MCU/USART_1_RX: U3.102 (PA10); also elsewhere on the board
/VMS/MCU/USART_1_TX: U3.101 (PA9); also elsewhere on the board
/VMS/MCU/USART_2_RX: U3.78 (PD9); also elsewhere on the board
/VMS/MCU/USART_2_TX: U3.77 (PD8); also elsewhere on the board
GND: BT1.2 (-), C31.2, C32.2, J4.3, J4.5, J4.9, R93.2, U3.16 (VSS), U3.31 (VSSA), U3.38 (VSS), U3.51 (VSS), U3.61 (VSS), U3.83 (VSS), U3.94 (VSS), U3.107 (VSS), U3.120 (VSS), U3.130 (VSS); also elsewhere on the board
unnamed: C31.1, U3.71 (VCAP_1)
unnamed: C32.1, U3.106 (VCAP_2)
unnamed: D14.1 (K), R93.1
unnamed: D14.2 (A), U3.104 (PA12)

Notes on the sheet:
Low ESR
Used for EEPROM
Used for IMU
Pinmap ADC1_IN0-ADC1_IN7
Author: LF

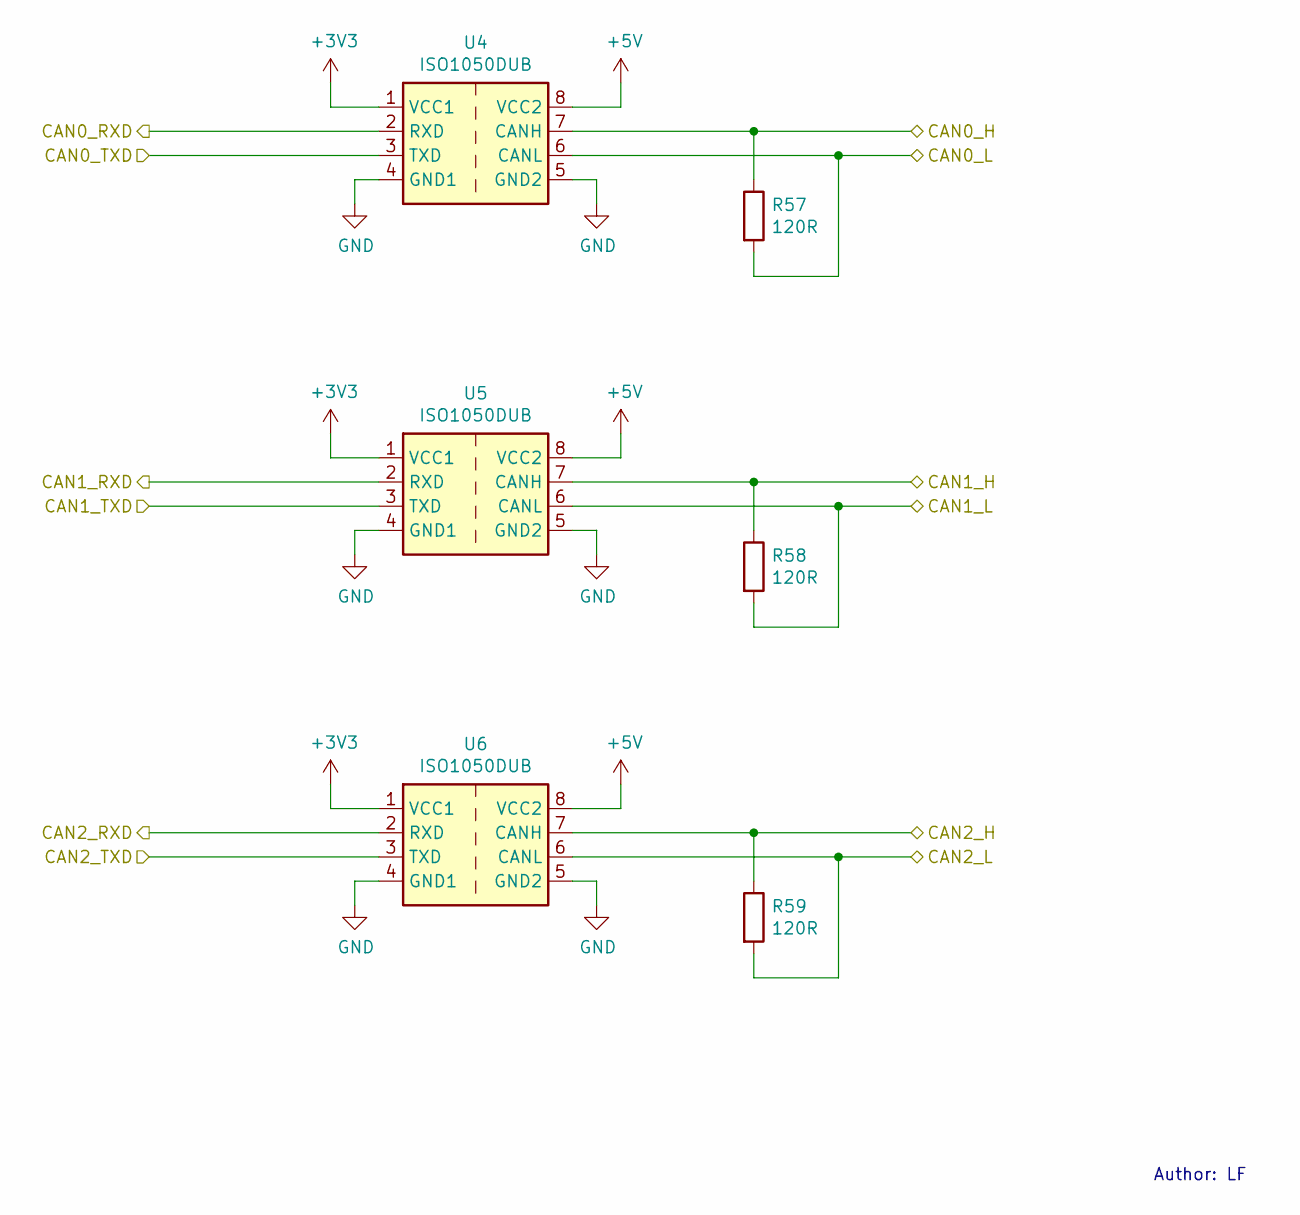
[picture p30: schematic VMS_CAN.kicad_sch]

Parts:
R57, R58, R59: 120R; R_0805_2012Metric
U4, U5, U6: ISO1050DUB; SOP-8_6.62x9.15mm_P2.54mm

Connections:
+5V: U4.8 (VCC2), U5.8 (VCC2), U6.8 (VCC2); also elsewhere on the board
/VMS/CAN0_H: R57.2, U4.6 (CANL); also elsewhere on the board
/VMS/CAN0_L: R57.1, U4.7 (CANH); also elsewhere on the board
/VMS/CAN1_H: R58.2, U5.6 (CANL); also elsewhere on the board
/VMS/CAN1_L: R58.1, U5.7 (CANH); also elsewhere on the board
/VMS/CAN2_H: R59.2, U6.6 (CANL); also elsewhere on the board
/VMS/CAN2_L: R59.1, U6.7 (CANH); also elsewhere on the board
/VMS/CAN/CAN0_RXD: U4.2 (RXD); also elsewhere on the board
/VMS/CAN/CAN0_TXD: U4.3 (TXD); also elsewhere on the board
/VMS/CAN/CAN1_RXD: U5.2 (RXD); also elsewhere on the board
/VMS/CAN/CAN1_TXD: U5.3 (TXD); also elsewhere on the board
/VMS/CAN/CAN2_RXD: U6.2 (RXD); also elsewhere on the board
/VMS/CAN/CAN2_TXD: U6.3 (TXD); also elsewhere on the board
GND: U4.4 (GND1), U4.5 (GND2), U5.4 (GND1), U5.5 (GND2), U6.4 (GND1), U6.5 (GND2); also elsewhere on the board

Notes on the sheet:
Author: LF

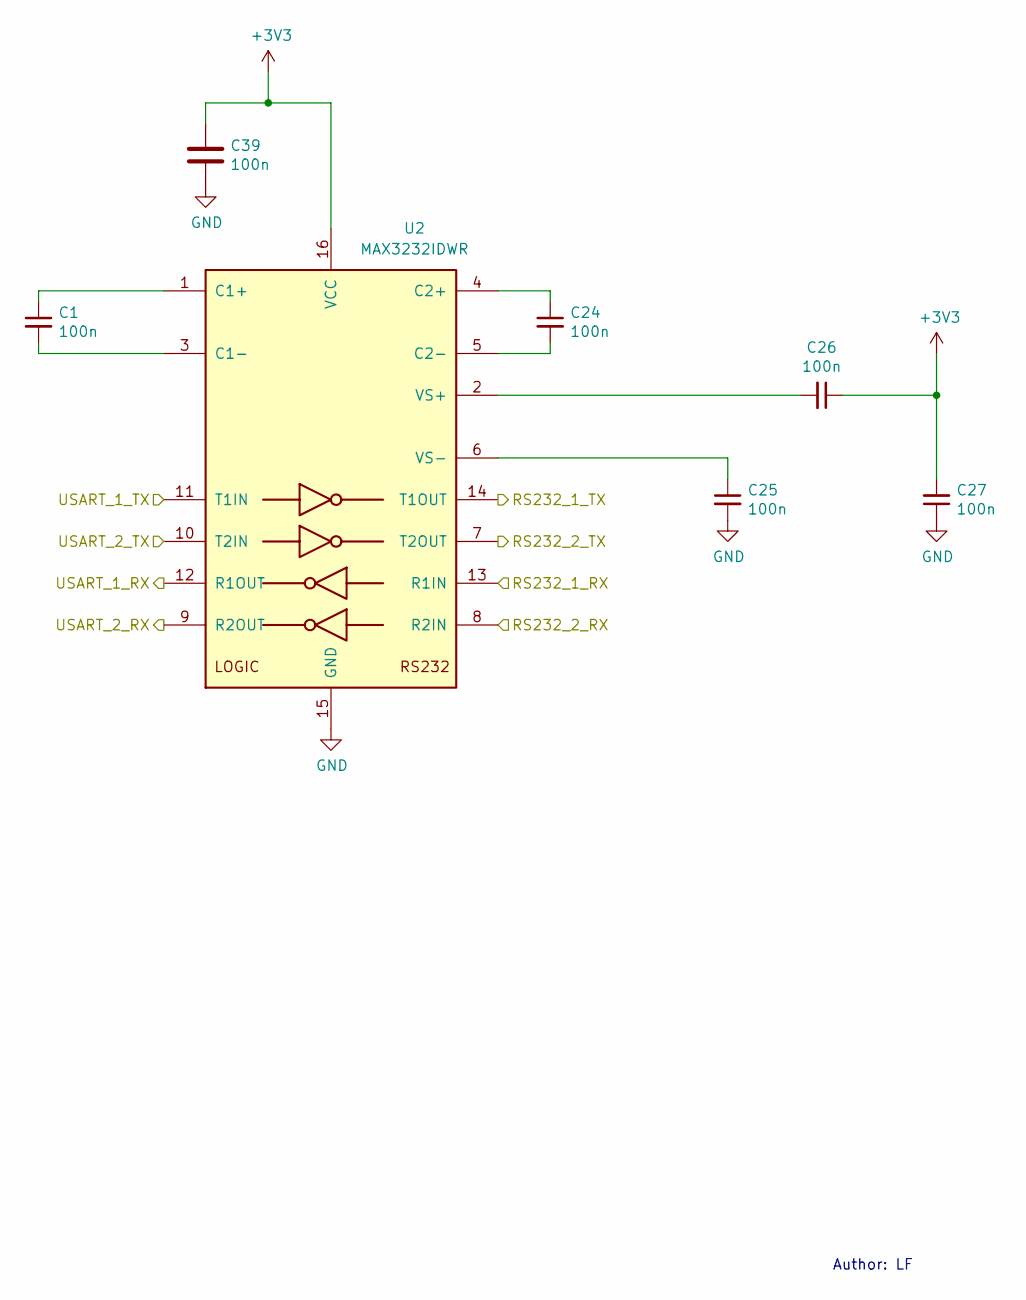
[picture p31: schematic VMS_RS232.kicad_sch]

Parts:
C1, C24, C25, C26, C27, C39: 100n; C_0805_2012Metric
U2: MAX3232IDWR; SOIC-16W_7.5x10.3mm_P1.27mm

Connections:
/VMS/ExpansionHeaders/RS232_2_RX: U2.8 (R2IN); also elsewhere on the board
/VMS/ExpansionHeaders/RS232_2_TX: U2.7 (T2OUT); also elsewhere on the board
/VMS/MCU/USART_1_RX: U2.12 (R1OUT); also elsewhere on the board
/VMS/MCU/USART_1_TX: U2.11 (T1IN); also elsewhere on the board
/VMS/MCU/USART_2_RX: U2.9 (R2OUT); also elsewhere on the board
/VMS/MCU/USART_2_TX: U2.10 (T2IN); also elsewhere on the board
/VMS/RS232_RX: U2.13 (R1IN); also elsewhere on the board
/VMS/RS232_TX: U2.14 (T1OUT); also elsewhere on the board
GND: C25.2, C27.1, C39.2, U2.15 (GND); also elsewhere on the board
unnamed: C1.1, U2.1 (C1+)
unnamed: C1.2, U2.3 (C1-)
unnamed: C24.1, U2.4 (C2+)
unnamed: C24.2, U2.5 (C2-)
unnamed: C25.1, U2.6 (VS-)
unnamed: C26.2, U2.2 (VS+)

Notes on the sheet:
Author: LF

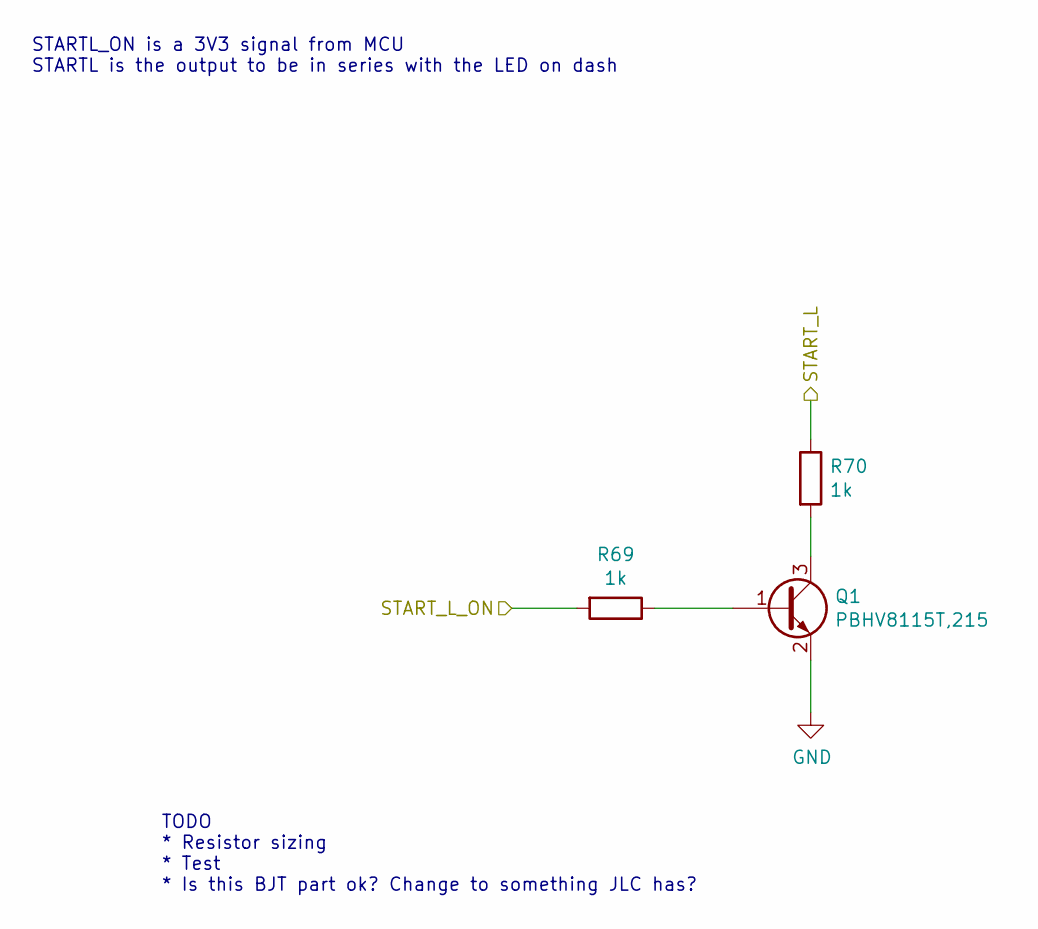
[picture p32: schematic VMS_LEDDriver.kicad_sch]

Parts:
Q1: PBHV8115T,215; SOT-23
R69, R70: 1k; R_0805_2012Metric

Connections:
/VMS/LEDDriver/START_L_ON: R69.2; also elsewhere on the board
/VMS/START_L: R70.1; also elsewhere on the board
GND: Q1.2 (E); also elsewhere on the board
unnamed: Q1.1 (B), R69.1
unnamed: Q1.3 (C), R70.2

Notes on the sheet:
STARTL_ON is a 3V3 signal from MCU STARTL is the output to be in series with the LED on dash
TODO * Resistor sizing * Test * Is this BJT part ok? Change to something JLC has?

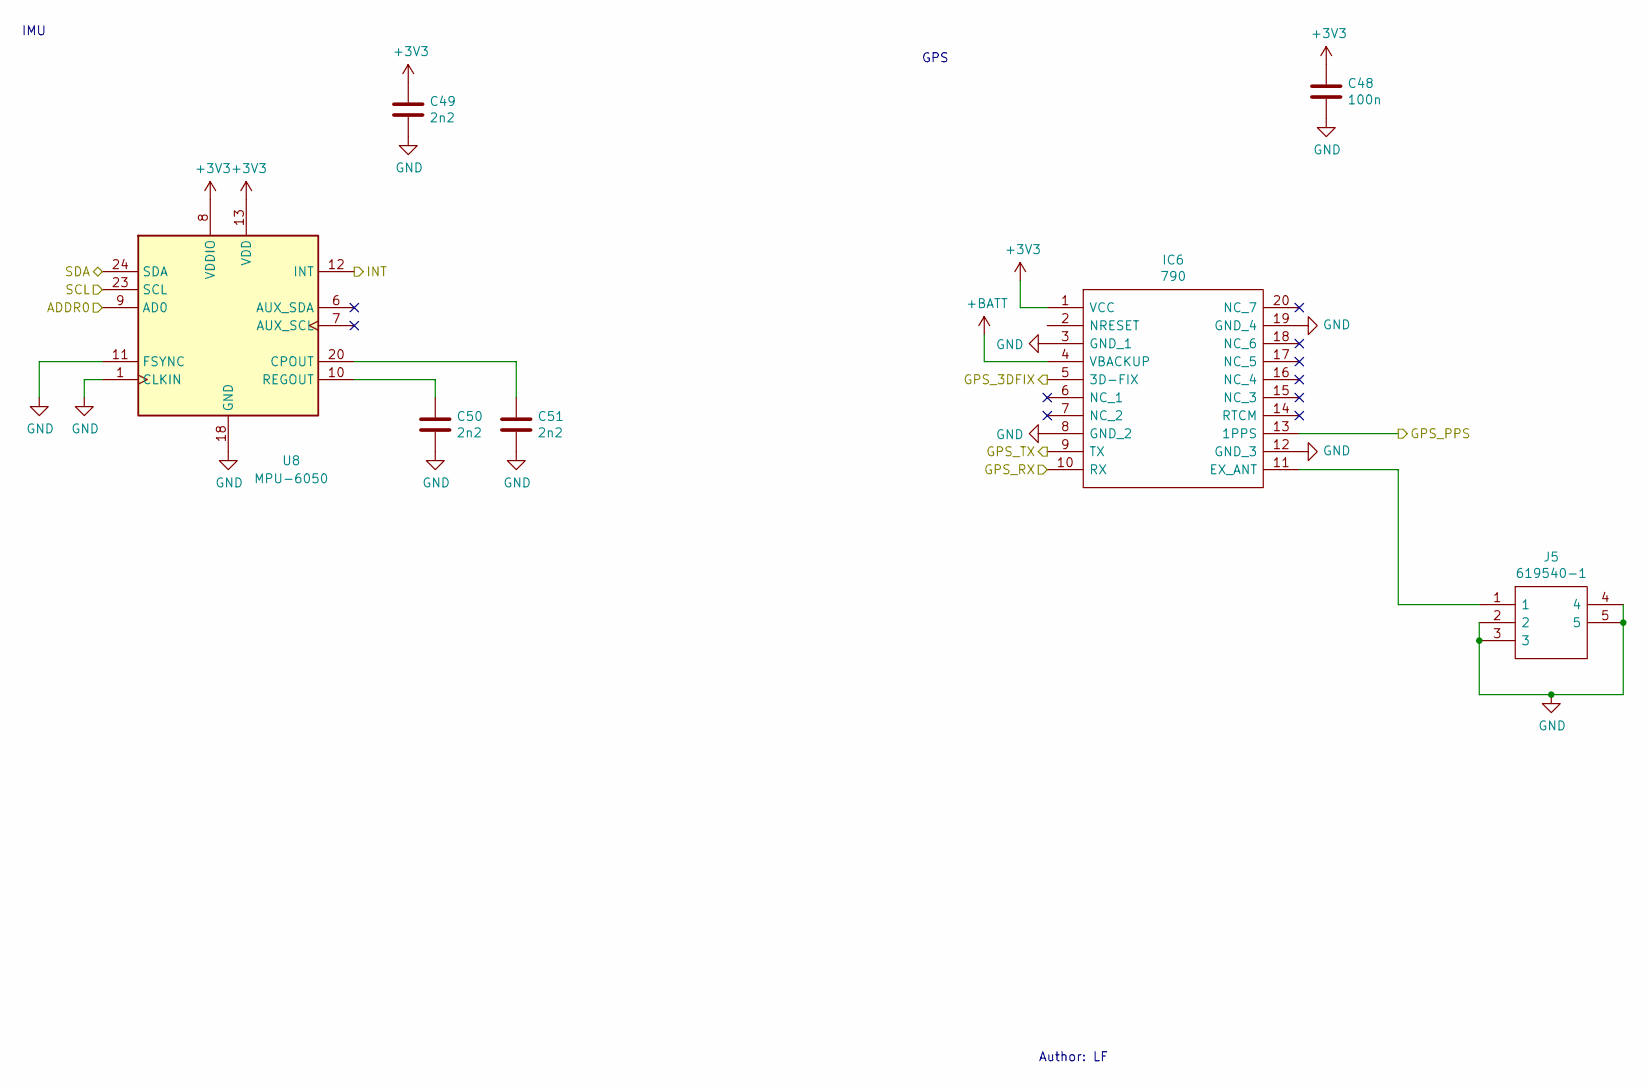
[picture p33: schematic VMS_Sensors.kicad_sch]

Parts:
C48: 100n; C_0805_2012Metric
C49, C50, C51: 2n2; C_0805_2012Metric
IC6: 790; Manufacturer_Part_Number 790; Mouser Part Number 485-790
J5: 619540-1; 6195401; Manufacturer_Part_Number 619540-1; Mouser Part Number 571-619540-1
U8: MPU-6050; InvenSense_QFN-24_4x4mm_P0.5mm

Connections:
+BATT: IC6.4 (VBACKUP); also elsewhere on the board
/VMS/MCU/GPS_3DFIX: IC6.5 (3D-FIX); also elsewhere on the board
/VMS/MCU/GPS_PPS: IC6.13 (1PPS); also elsewhere on the board
/VMS/MCU/GPS_RX: IC6.10 (RX); also elsewhere on the board
/VMS/MCU/GPS_TX: IC6.9 (TX); also elsewhere on the board
/VMS/MCU/I2C1_SCL: U8.23 (SCL); also elsewhere on the board
/VMS/MCU/I2C1_SDA: U8.24 (SDA); also elsewhere on the board
/VMS/MCU/IMU_ADDR0: U8.9 (AD0); also elsewhere on the board
/VMS/MCU/IMU_INT: U8.12 (INT); also elsewhere on the board
GND: C48.2, C49.2, C50.2, C51.2, IC6.3 (GND_1), IC6.8 (GND_2), IC6.12 (GND_3), IC6.19 (GND_4), J5.2, J5.3, J5.4, J5.5, U8.1 (CLKIN), U8.11 (FSYNC), U8.18 (GND); also elsewhere on the board
unnamed: C50.1, U8.10 (REGOUT)
unnamed: C51.1, U8.20 (CPOUT)
unnamed: IC6.11 (EX_ANT), J5.1

Notes on the sheet:
GPS
Author: LF
IMU

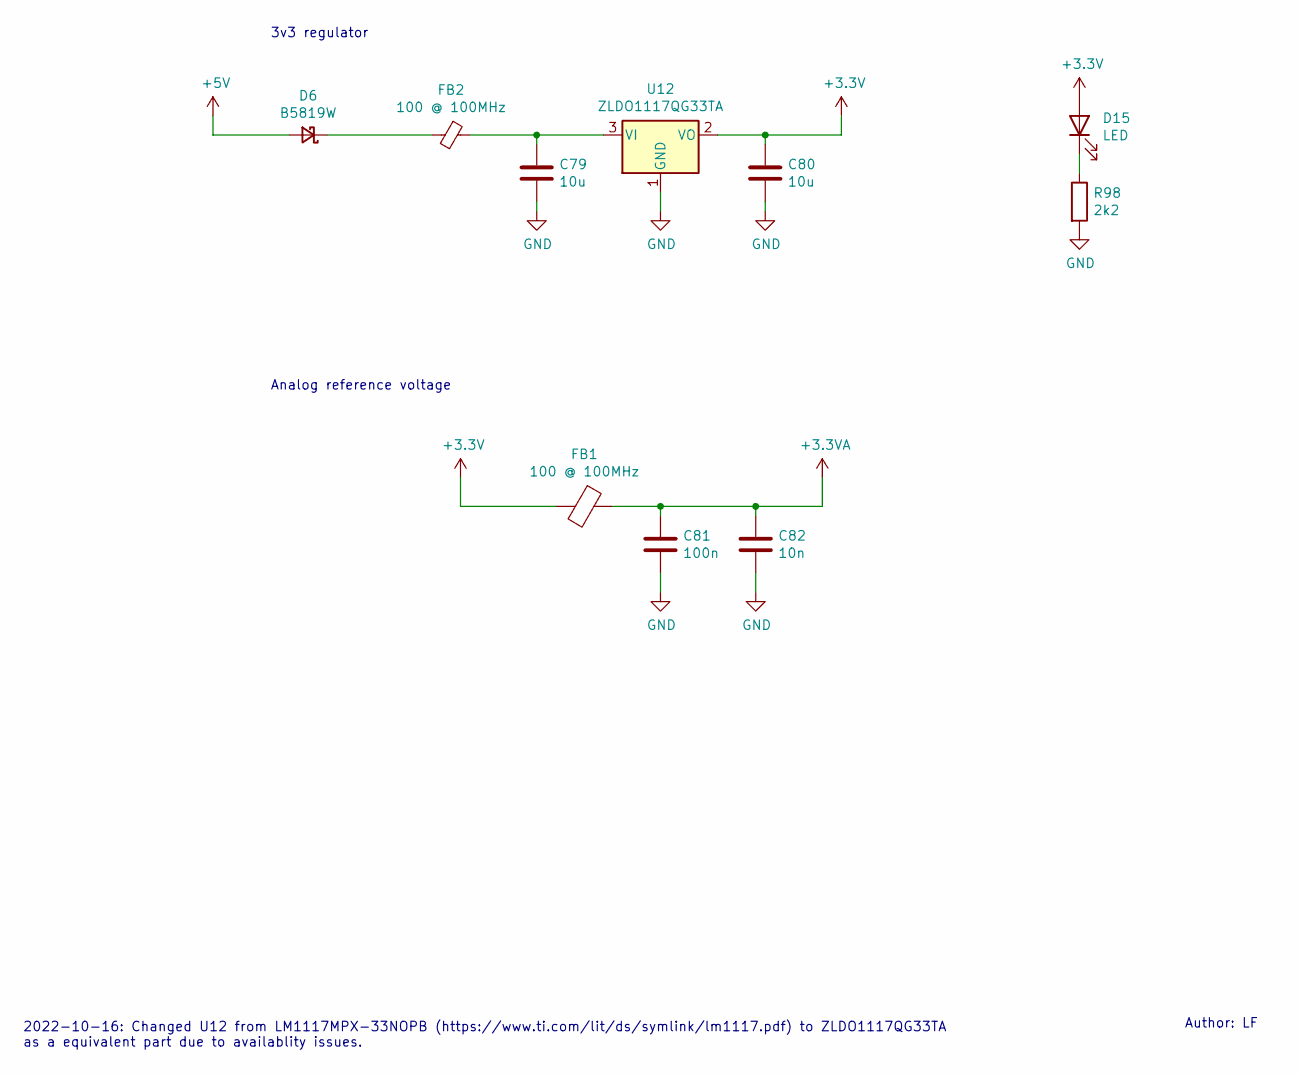
[picture p34: schematic VMS_Power.kicad_sch]

Parts:
C79, C80: 10u; C_0805_2012Metric
C81: 100n; C_0805_2012Metric
C82: 10n; C_0805_2012Metric
D6: B5819W; D_SOD-123
D15: LED; LED_0805_2012Metric
FB1, FB2: 100 @ 100MHz; L_0805_2012Metric
R98: 2k2; R_0805_2012Metric
U12: ZLDO1117QG33TA; SOT-223-3_TabPin2

Connections:
+3.3VA: C81.1, C82.1, FB1.1; also elsewhere on the board
+5V: D6.2 (A); also elsewhere on the board
GND: C79.2, C80.2, C81.2, C82.2, R98.2, U12.1 (GND); also elsewhere on the board
unnamed: C79.1, FB2.1, U12.3 (VI)
unnamed: D6.1 (K), FB2.2
unnamed: D15.1 (K), R98.1

Notes on the sheet:
2022-10-16: Changed U12 from LM1117MPX-33NOPB (https://www.ti.com/lit/ds/symlink/lm1117.pdf) to ZLDO1117QG33TA as a equivalent part due to availablity issues.
Author: LF
3v3 regulator
Analog reference voltage

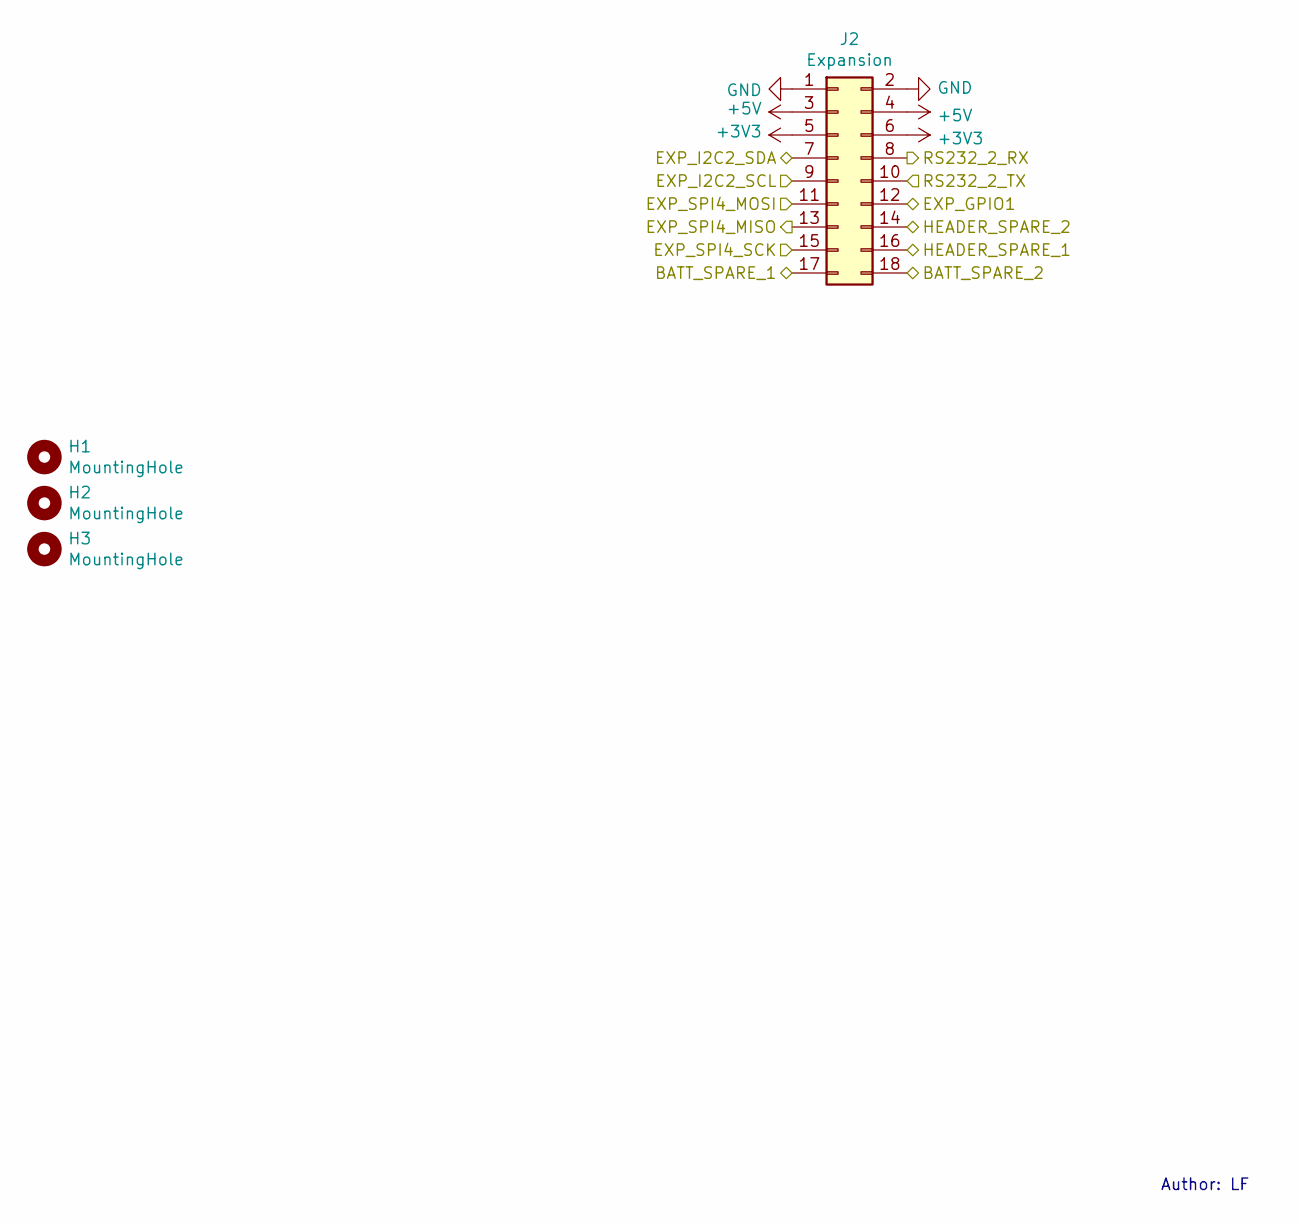
[picture p35: schematic VMS_Expansion.kicad_sch]

Parts:
H1, H2, H3: MountingHole; MountingHole_2.5mm
J2: Expansion; PinHeader_2x09_P2.54mm_Vertical

Connections:
+5V: J2.3, J2.4; also elsewhere on the board
/VMS/BATT_SPARE_1: J2.17; also elsewhere on the board
/VMS/BATT_SPARE_2: J2.18; also elsewhere on the board
/VMS/ExpansionHeaders/EXP_GPIO1: J2.12; also elsewhere on the board
/VMS/ExpansionHeaders/EXP_I2C2_SCL: J2.9; also elsewhere on the board
/VMS/ExpansionHeaders/EXP_I2C2_SDA: J2.7; also elsewhere on the board
/VMS/ExpansionHeaders/EXP_SPI4_MISO: J2.13; also elsewhere on the board
/VMS/ExpansionHeaders/EXP_SPI4_MOSI: J2.11; also elsewhere on the board
/VMS/ExpansionHeaders/EXP_SPI4_SCK: J2.15; also elsewhere on the board
/VMS/ExpansionHeaders/RS232_2_RX: J2.8; also elsewhere on the board
/VMS/ExpansionHeaders/RS232_2_TX: J2.10; also elsewhere on the board
/VMS/HEADER_SPARE_1: J2.16; also elsewhere on the board
/VMS/VMS_PROG: J2.14; also elsewhere on the board
GND: J2.1, J2.2; also elsewhere on the board

Notes on the sheet:
Author: LF

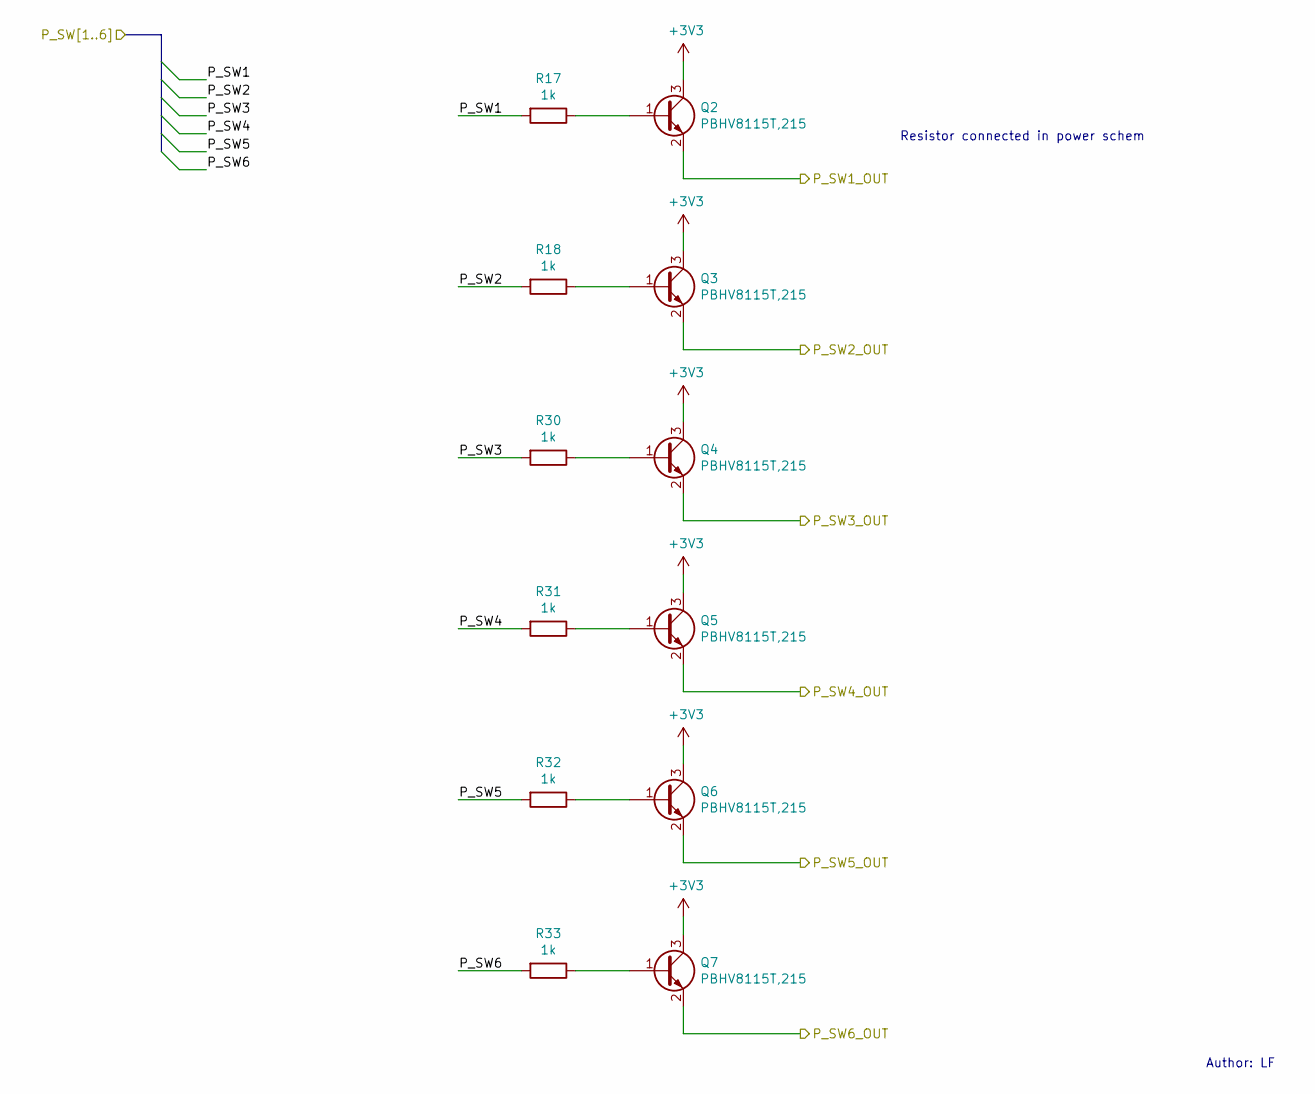
[picture p36: schematic VMS_PDMSwitch.kicad_sch]

Parts:
Q2, Q3, Q4, Q5, Q6, Q7: PBHV8115T,215; SOT-23
R17, R18, R30, R31, R32, R33: 1k; R_0805_2012Metric

Connections:
/POWER/P_SW1: Q2.2 (E); also elsewhere on the board
/POWER/P_SW2: Q3.2 (E); also elsewhere on the board
/POWER/P_SW3: Q4.2 (E); also elsewhere on the board
/POWER/P_SW4: Q5.2 (E); also elsewhere on the board
/POWER/P_SW5: Q6.2 (E); also elsewhere on the board
/POWER/P_SW6: Q7.2 (E); also elsewhere on the board
/VMS/MCU/P_SW1: R17.2; also elsewhere on the board
/VMS/MCU/P_SW2: R18.2; also elsewhere on the board
/VMS/MCU/P_SW3: R30.2; also elsewhere on the board
/VMS/MCU/P_SW4: R31.2; also elsewhere on the board
/VMS/MCU/P_SW5: R32.2; also elsewhere on the board
/VMS/MCU/P_SW6: R33.2; also elsewhere on the board
unnamed: Q2.1 (B), R17.1
unnamed: Q3.1 (B), R18.1
unnamed: Q4.1 (B), R30.1
unnamed: Q5.1 (B), R31.1
unnamed: Q6.1 (B), R32.1
unnamed: Q7.1 (B), R33.1

Notes on the sheet:
Author: LF
Resistor connected in power schem
