lflaherty/ev-ecu/hardware/kicad_project/ECU.kicad_pcb

## KiCad design hardware/kicad_project/ECU.kicad_pcb (continued)

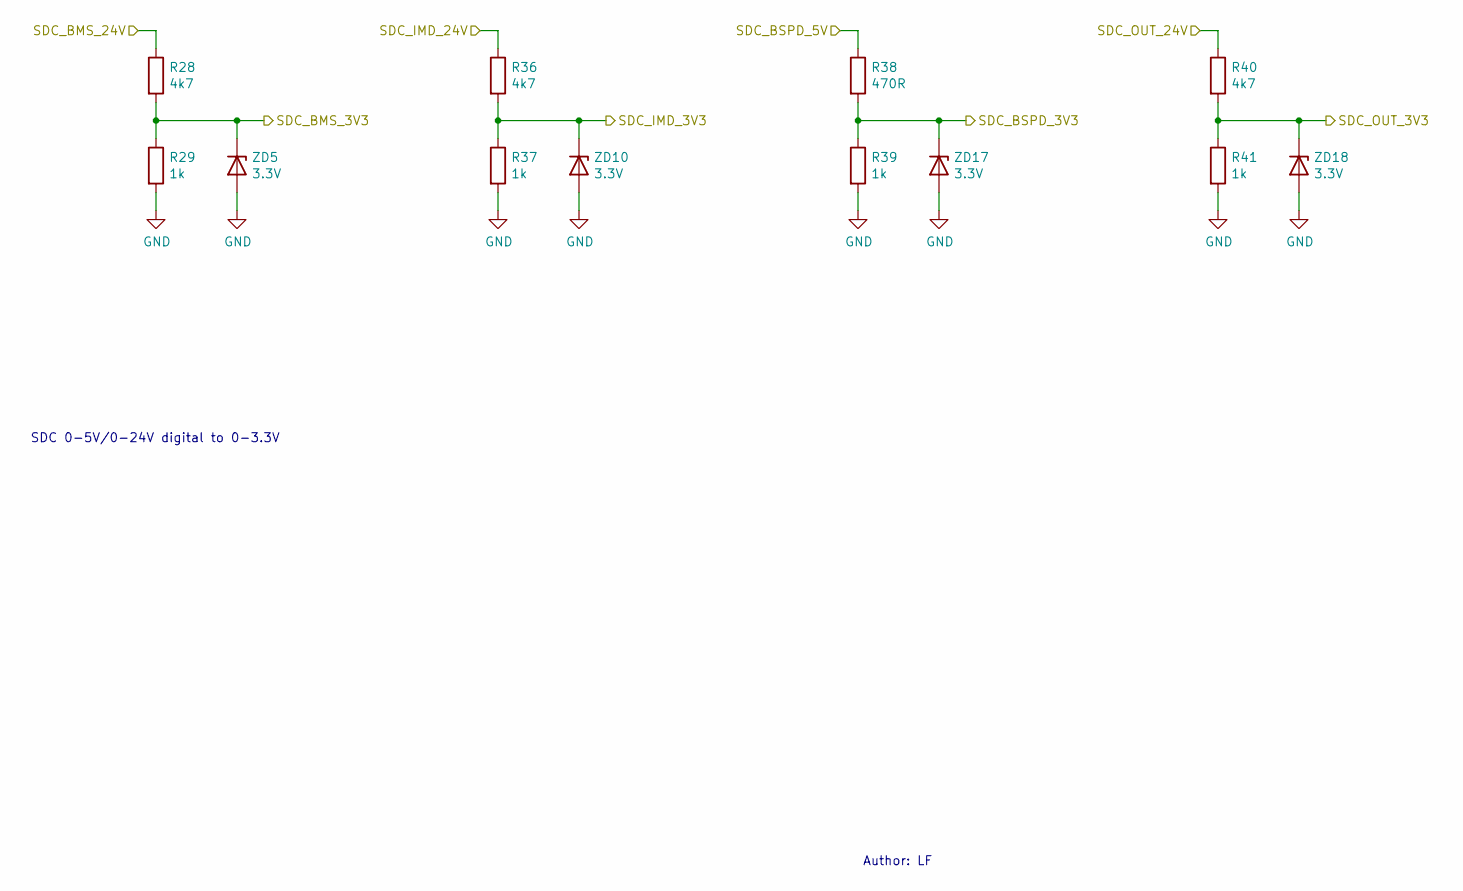
[picture p37: schematic VMD_SDCStateReg.kicad_sch]

Parts:
R28, R36, R40: 4k7; R_0805_2012Metric
R29, R37, R39, R41: 1k; R_0805_2012Metric
R38: 470R; R_0805_2012Metric
ZD5, ZD10, ZD17, ZD18: 3.3V; D_MiniMELF

Connections:
/BSPD/BSPD_ERR: R38.1; also elsewhere on the board
/SDC/BMS_ERR: R28.1; also elsewhere on the board
/SDC/IMD_ERR: R36.1; also elsewhere on the board
/SDC/SDC_OUT: R40.1; also elsewhere on the board
/VMS/MCU/SDC_BMS: R28.2, R29.1, ZD5.1 (K); also elsewhere on the board
/VMS/MCU/SDC_BSPD: R38.2, R39.1, ZD17.1 (K); also elsewhere on the board
/VMS/MCU/SDC_IMD: R36.2, R37.1, ZD10.1 (K); also elsewhere on the board
/VMS/MCU/SDC_OUT: R40.2, R41.1, ZD18.1 (K); also elsewhere on the board
GND: R29.2, R37.2, R39.2, R41.2, ZD5.2 (A), ZD10.2 (A), ZD17.2 (A), ZD18.2 (A); also elsewhere on the board

Notes on the sheet:
Author: LF
SDC 0-5V/0-24V digital to 0-3.3V

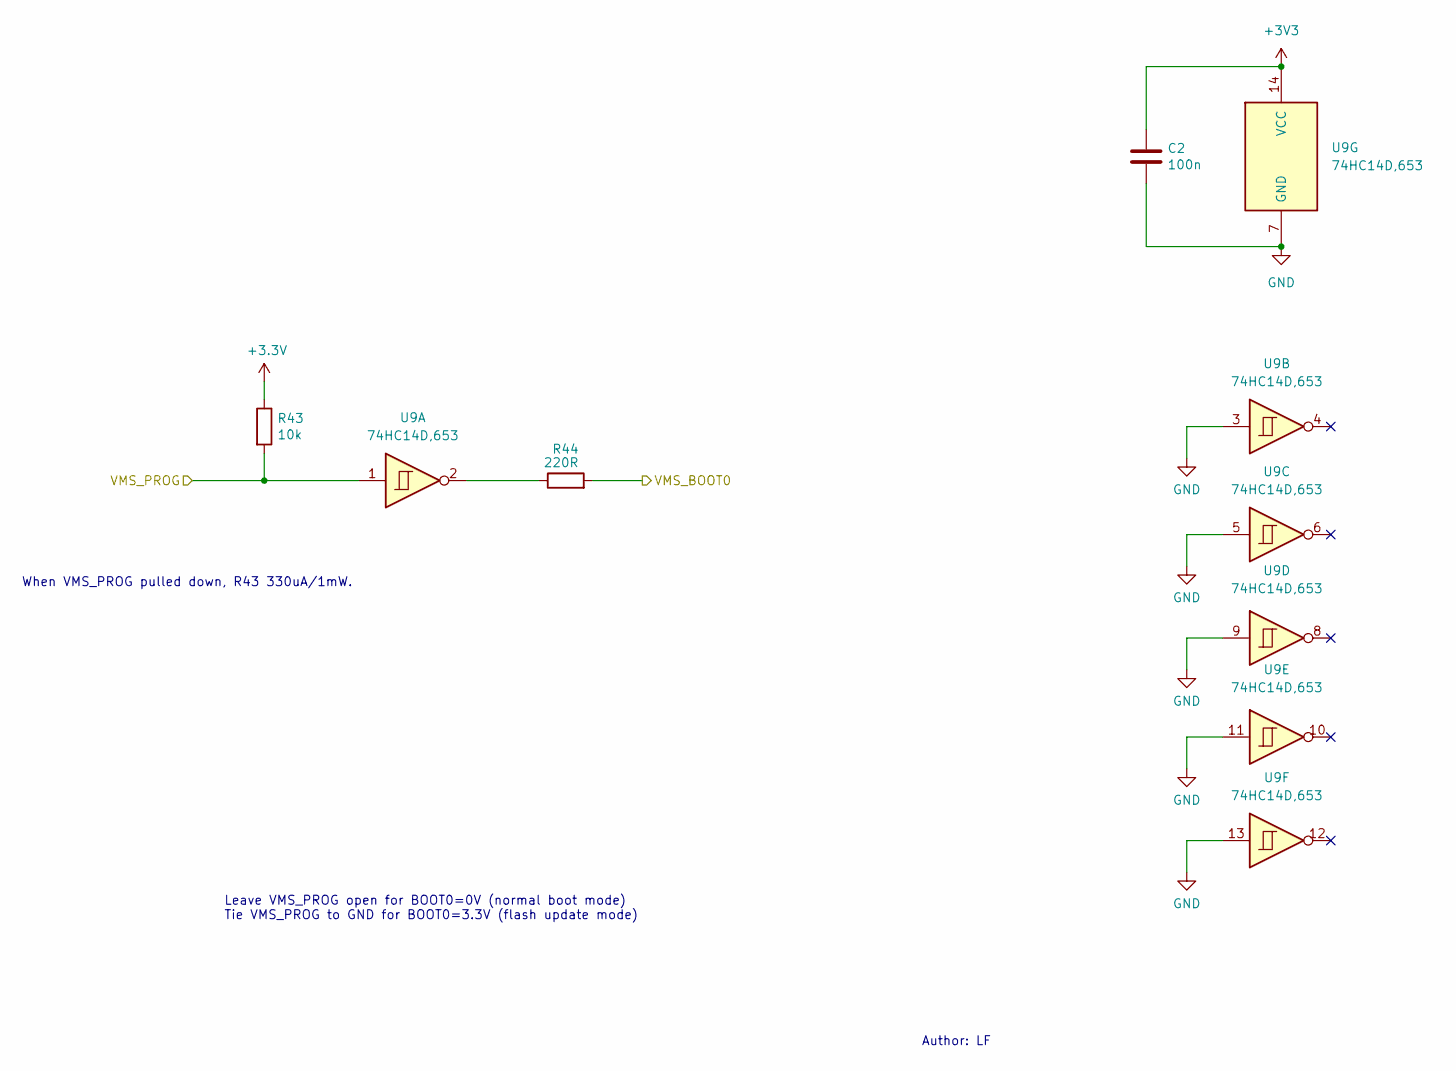
[picture p38: schematic VMS_PROG.kicad_sch]

Parts:
C2: 100n; C_0805_2012Metric
R43: 10k; R_0805_2012Metric
R44: 220R; R_0805_2012Metric
U9: 74HC14D,653; SOIC-14_3.9x8.7mm_P1.27mm

Connections:
/VMS/MCU/BOOT0_EXT: R44.2; also elsewhere on the board
/VMS/VMS_PROG: R43.2, U9.1; also elsewhere on the board
GND: C2.2, U9.3, U9.5, U9.7 (GND), U9.9, U9.11, U9.13; also elsewhere on the board
unnamed: R44.1, U9.2

Notes on the sheet:
Author: LF
Leave VMS_PROG open for BOOT0=0V (normal boot mode) Tie VMS_PROG to GND for BOOT0=3.3V (flash update mode)
When VMS_PROG pulled down, R43 330uA/1mW.

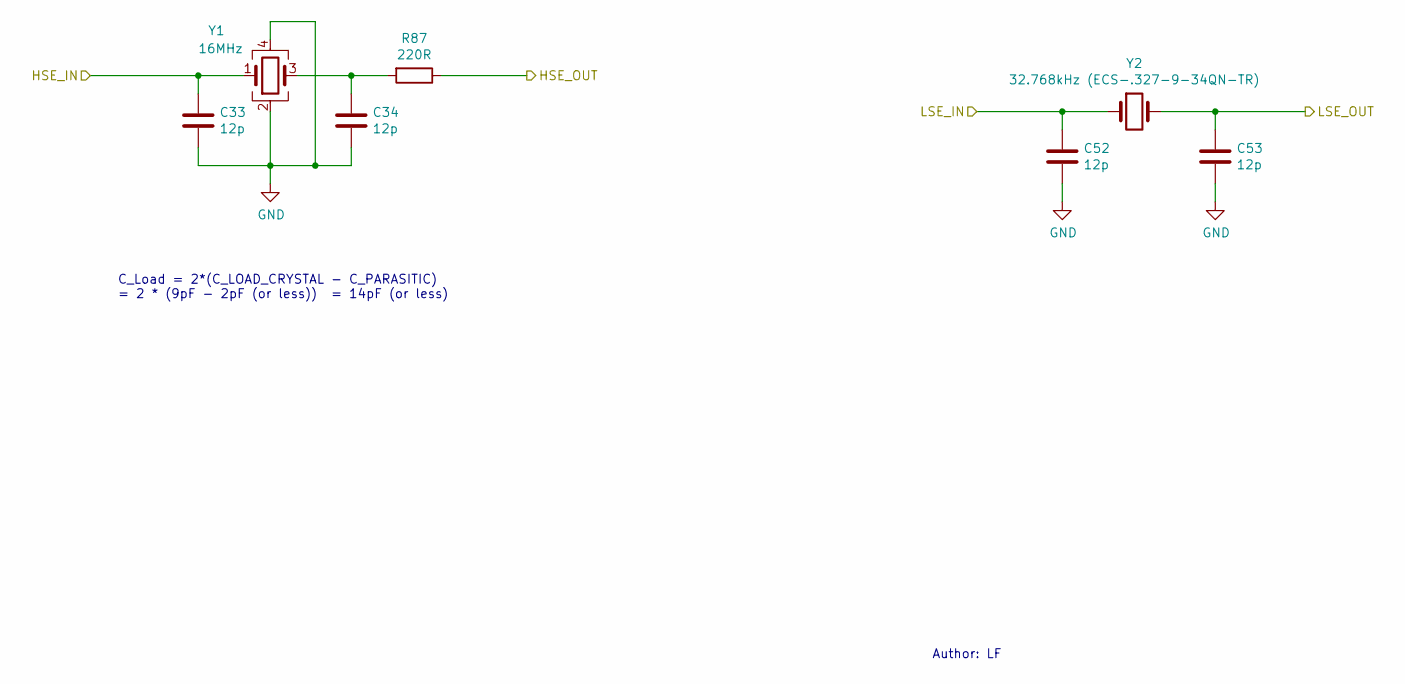
[picture p39: schematic MCU_Crystals.kicad_sch]

Parts:
C33, C34, C52, C53: 12p; C_0805_2012Metric
R87: 220R; R_0805_2012Metric
Y1: 16MHz; Crystal_SMD_3225-4Pin_3.2x2.5mm
Y2: 32.768kHz (ECS-.327-9-34QN-TR); Crystal_SMD_3215-2Pin_3.2x1.5mm

Connections:
/VMS/MCU/HSE_IN: C33.1, Y1.1; also elsewhere on the board
/VMS/MCU/HSE_OUT: R87.1; also elsewhere on the board
/VMS/MCU/LSE_IN: C52.1, Y2.1; also elsewhere on the board
/VMS/MCU/LSE_OUT: C53.1, Y2.2; also elsewhere on the board
GND: C33.2, C34.2, C52.2, C53.2, Y1.2, Y1.4; also elsewhere on the board
unnamed: C34.1, R87.2, Y1.3

Notes on the sheet:
Author: LF
C_Load = 2*(C_LOAD_CRYSTAL - C_PARASITIC) = 2 * (9pF - 2pF (or less)) = 14pF (or less)

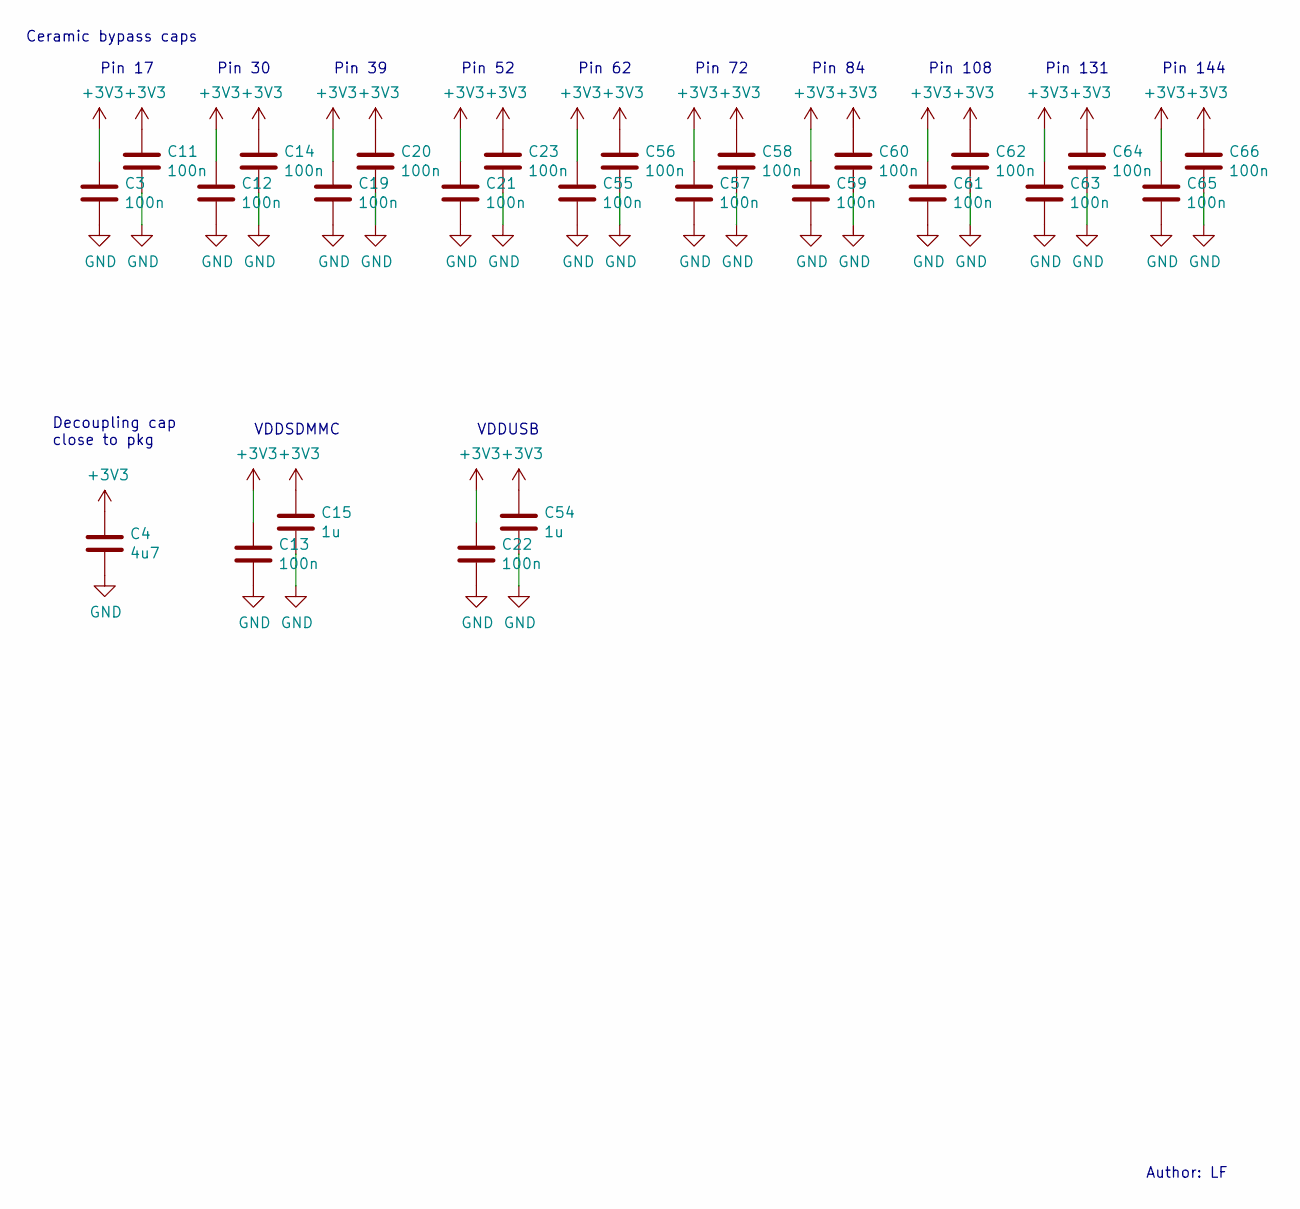
[picture p40: schematic MCU_Caps.kicad_sch]

Parts:
C3, C11, C12, C13, C14, C19, C20, C21, C22, C23, C55, C56, C57, C58, C59, C60, C61, C62, C63, C64, C65, C66: 100n; C_0805_2012Metric
C4: 4u7; C_0805_2012Metric
C15, C54: 1u; C_0805_2012Metric

Connections:
GND: C3.2, C4.2, C11.2, C12.2, C13.2, C14.2, C15.2, C19.2, C20.2, C21.2, C22.2, C23.2, C54.2, C55.2, C56.2, C57.2, C58.2, C59.2, C60.2, C61.2, C62.2, C63.2, C64.2, C65.2, C66.2; also elsewhere on the board

Notes on the sheet:
Pin 62
Pin 17
Pin 72
Pin 52
Pin 131
VDDUSB
Pin 144
Pin 108
Pin 30
Decoupling cap close to pkg
VDDSDMMC
Ceramic bypass caps
Author: LF
Pin 39
Pin 84

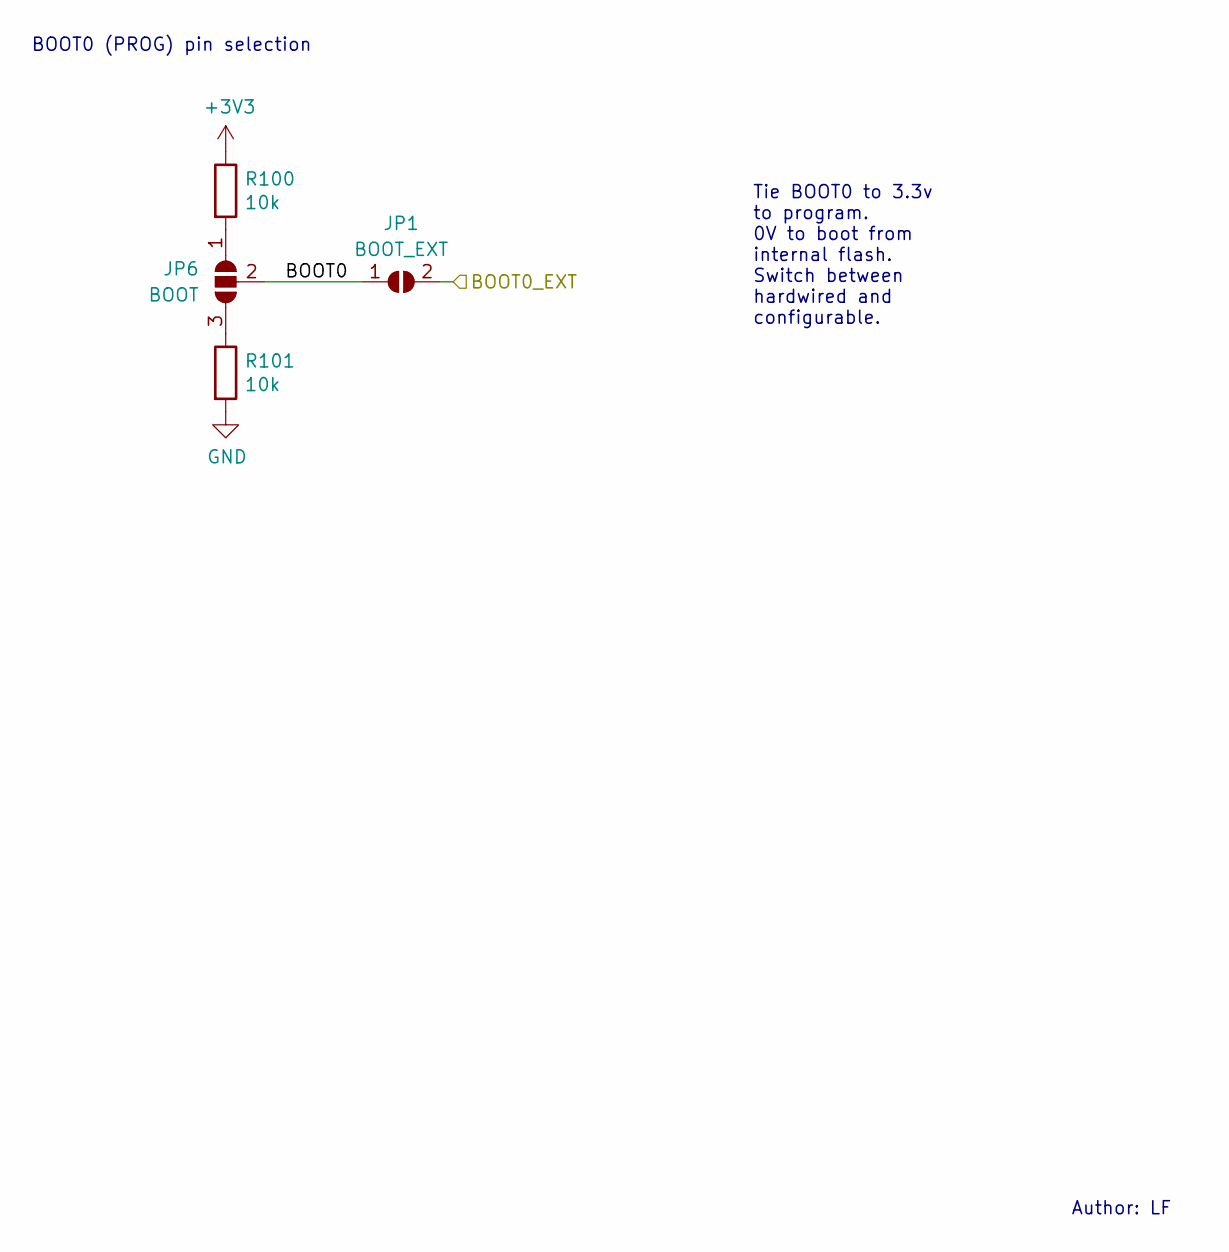
[picture p41: schematic MCU_ProgSel.kicad_sch]

Parts:
JP1: BOOT_EXT; SolderJumper-2_P1.3mm_Open_RoundedPad1.0x1.5mm
JP6: BOOT; SolderJumper-3_P1.3mm_Open_RoundedPad1.0x1.5mm_NumberLabels
R100, R101: 10k; R_0805_2012Metric

Connections:
/VMS/MCU/BOOT0: JP1.1 (A), JP6.2 (C); also elsewhere on the board
/VMS/MCU/BOOT0_EXT: JP1.2 (B); also elsewhere on the board
GND: R101.2; also elsewhere on the board
unnamed: JP6.1 (A), R100.2
unnamed: JP6.3 (B), R101.1

Notes on the sheet:
Tie BOOT0 to 3.3v to program. 0V to boot from internal flash. Switch between hardwired and configurable.
BOOT0 (PROG) pin selection
Author: LF

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
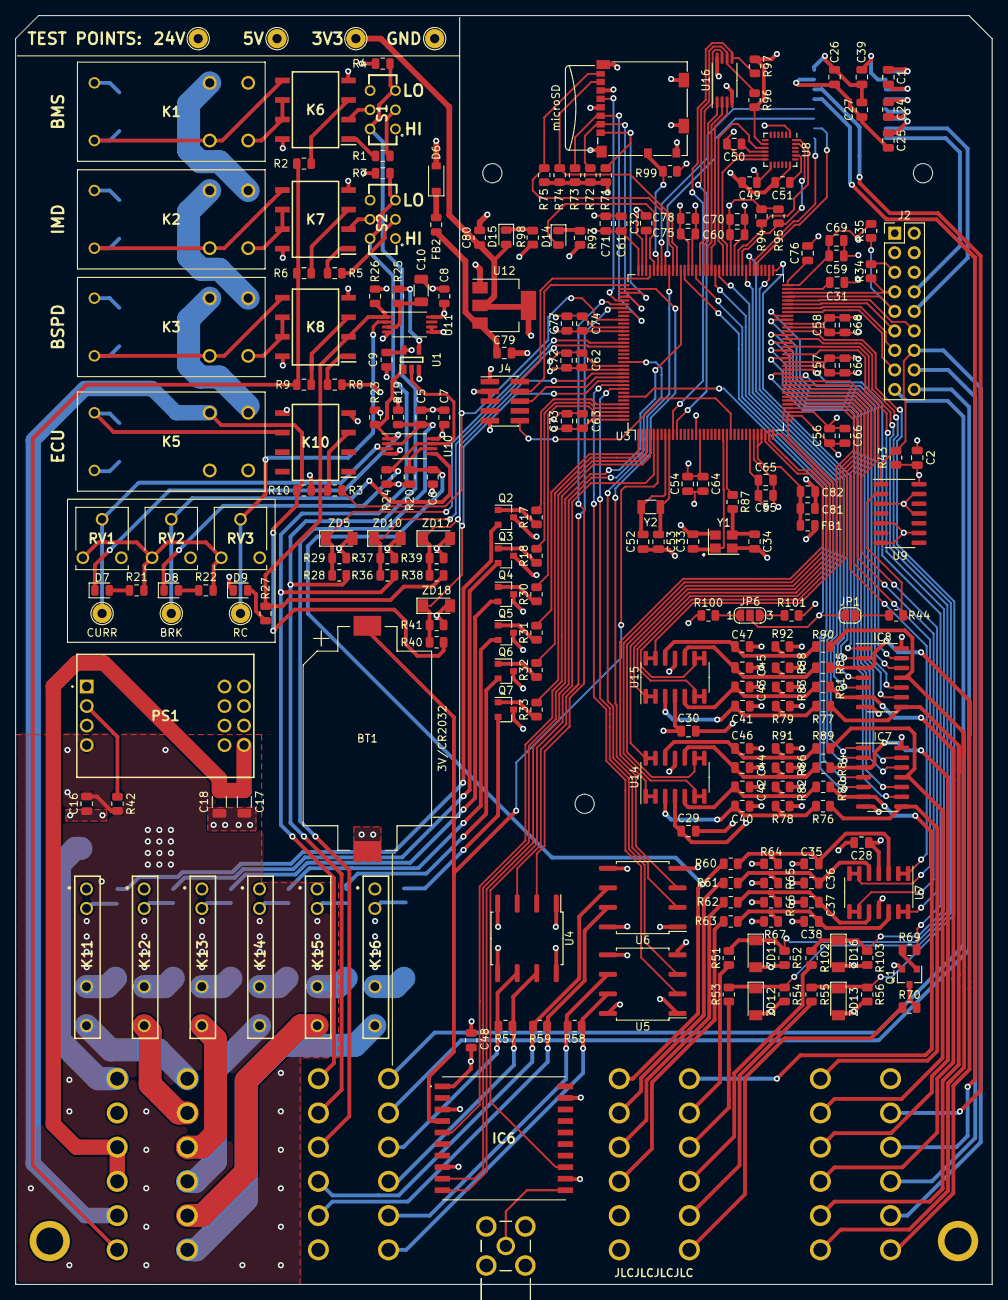
[picture p42: board ECU.kicad_pcb from above]

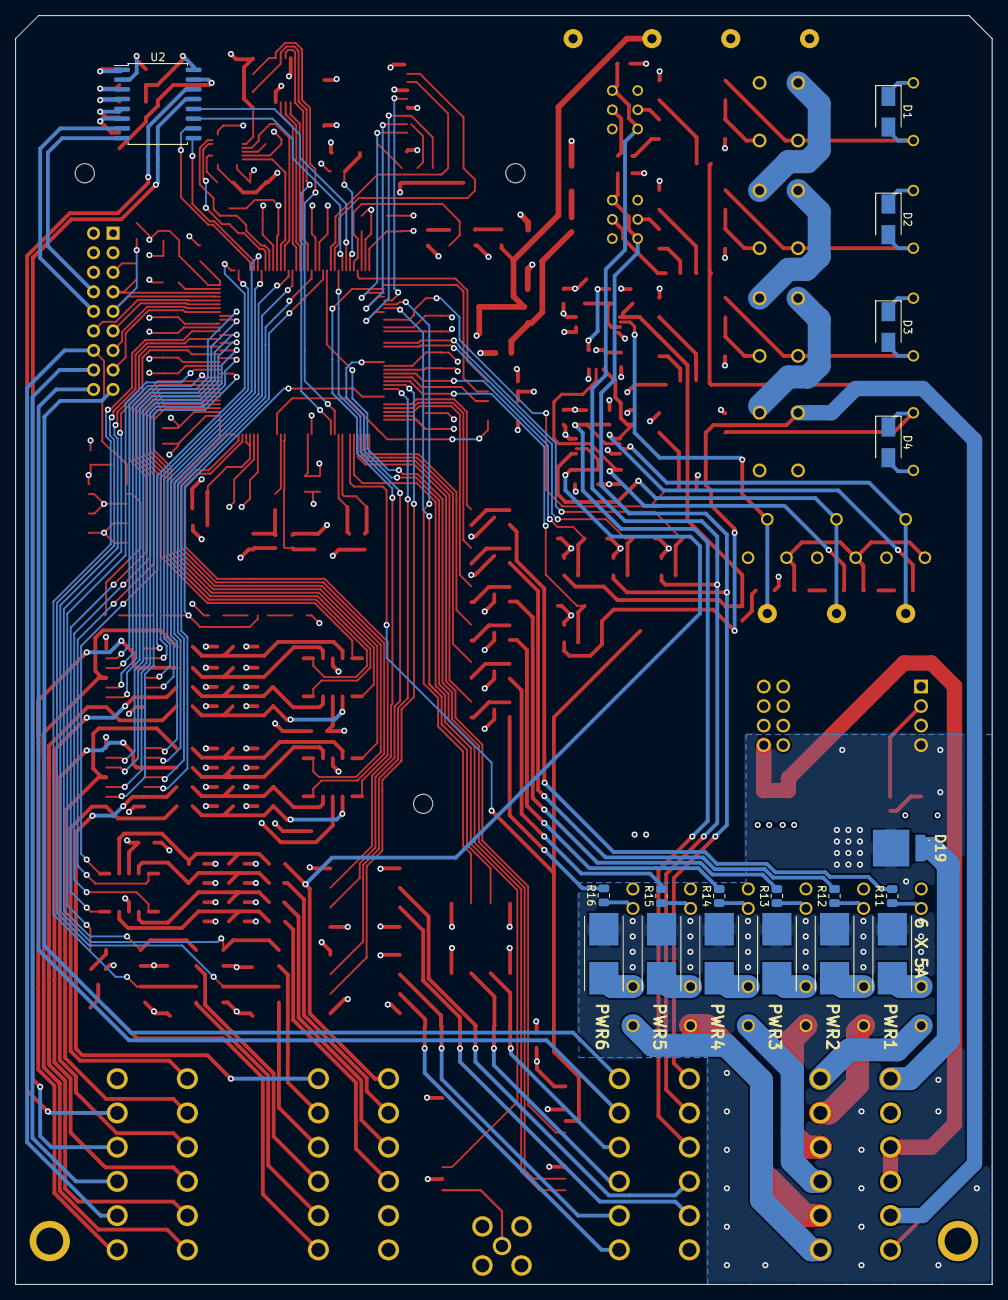
[picture p43: board ECU.kicad_pcb from below]

Board: 4 copper layers, 127.0 x 165.0 mm, 258 parts (18 on the bottom side), 231 nets.

Other parts of the board:
C67, C68, C69, C70, C71, C72, C73, C77, C78: 100n; C_0805_2012Metric
C74, C75: 1u; C_0805_2012Metric
C76: 4u7; C_0805_2012Metric

Their connections:
GND: C67.2, C68.2, C69.2, C70.2, C71.2, C72.2, C73.2, C74.2, C75.2, C76.2, C77.2, C78.2; also elsewhere on the board
